HonestLeon/2027_Embedded_Buff/docs/从机代码重构计划.md

# 从机代码重构计划（分阶段）

> 对象：`2027_Embedded_Buff_Slave/`（打符灯板固件）
> 依据：《从机重构清单.md》《代码架构设计.md》《能量机关规则.pdf》5.5.2.1
> 已确认的前置：**CubeMX 配置已完成并校验通过**（6 通道 PWM + 6 条 DMA 全部 `MEMORY_TO_PERIPH`、
> 10 路 EXTI、NVIC 优先级、CAN1=1Mbps+ART/ABOM、USER CODE 区保留）
> 目标：与主机同构的 `config / bsp / application` 分层；**复用主机框架，只换业务层**

---

## 一、总体策略

1. **最大化复用**：主机的 `config/bsp` 框架与 `application/buff.c` 的**协议段**已可直接继承，
   从机真正要新写的是 **`hit_detect`（击打采集）+ 从机状态机 + 灯板图案库**；
2. **口径继承（不标定）**：**硬件与 2025 完全相同** ⇒ 老从机的灯数（87/262/320/120/92）与
   "索引↔功能"映射**就是规格**，直接继承 `config_ws2812.h` / `config_light.h`；
   逐条点亮只作为**排障工具**保留（见《灯带白光自检与排障》），不再是必经阶段；
3. **自底向上，但阶段间不设台架闸门**：S3→S4→S5→S6 **一次性连续写完**，每阶段只过“静态可验项”
   （编译 0 error 0 warning、表/缓冲一致、与主机协议段 diff 一致、代码走查），
   **所有物理验证集中到 S7 一次做**（省反复烧录/上板；代价与对策见 §四 风险表末两行）；
   **S8（进度条）是唯一例外**——它的渲染几何必须"台架 + 机械布局"才能定，排在 S7 之后、复用 S7 台架环境；
4. **时序纪律**：从机必须 **1ms 级排空 CAN**（大符轮次切换的"熄灭/点亮"两帧仅隔 150ms），
   且**禁止 `HAL_Delay` 阻塞**（老从机 200ms 阻塞是"熄灭不稳定"的根因）；
5. **⚠ 从机板未接拨码开关**（实测）：PD2/PB3/PB4 悬空 + 内部上拉 → 三个 `SW_*` 恒为高（恒"激活"），
   因此**颜色/大小符一律取 CAN 帧**（[4]/[2]），**自检只能用 `DEBUG_TEST_MODE` 宏触发**
   （拿 `SW2` 当触发会一上电就永久扫描；`TEST_TRIGGER_USE_SW2` 已置 0）。
6. **测试方法（定死，不再讨论）**：主判据 = **实机观察**（灯带外观、该熄的熄没熄、进度条、环数）
   + Keil 调试器 **Watch 全局变量/结构体快照**；**CAN 分析仪 / CAN 盒不进计划、不作任何阶段判据**。
   配套要求：**每阶段必须交付一个可 Watch 的快照结构体**，S7 只靠变量就能分层定位——
   `S3=g_buff_rx`✅ / `S4=g_dbg_hit`✅ / `S5=g_dbg_slv`✅ / `S6=g_dbg_pat`✅；对外发帧一律用**真主机**（或 5 板联机）。

```
S0 基线 ──► S1 config ──► S2 口径继承(✅无需标定)
                                  └─►╒══════ 连续编码块：阶段间不上台架 ══════╕
                                     ║ S3 bsp 适配  →  S4 hit_detect         ║
                                     ║ S5 从机状态机 →  S6 灯板图案库          ║
                                     ╘═══════════════╤═══════════════════════╛
                                                     └─► S7 唯一一次台架：实机观察 + Watch
                                                                  └─► S8 进度条专项（复用台架环境）
```

---

## 二、阶段任务分解

### S0 基线确认与工程接入（0.5 天）

| # | 任务 | 说明 |
|---|---|---|
| S0.1 | ~~CubeMX 配置~~ | ✅ 已完成并校验（见本文件开头的前置说明） |
| S0.2 | ~~工程改名~~ **已定：不改** | 从机目录内的 `.ioc`/Keil 工程名沿用 `..._Master`（改名要重生 `MDK-ARM/` 并重配 Groups/包含路径，收益仅是名字）。靠目录名 + `BOARD_ROLE_MASTER` 区分主从，结论见《遗留待办与开放问题》R3 |
| S0.3 | ~~编译基线~~ **✅ 2026-10-06** | 用 `arm-none-eabi-gcc -fsyntax-only`(-Wall -Wextra, HAL 头齐全)检查从机全部 config/bsp/application + `main.c`/`it.c`：0 error |
| S0.4 | ~~提交基线~~ **✅** | 从机 CubeMX 配置已随 `5674103`/`e6e113e` 入库 |

**验收**：编译通过；`.ioc` 校验 6 行 DMA 方向全为 `MEMORY_TO_PERIPH`；提交完成。
> 检查命令(本机无 Keil 命令行，语法/类型用 GCC 代跑，**最终 Rebuild 与烧录仍需在 Keil 里做一次**)：
> `arm-none-eabi-gcc -fsyntax-only -mcpu=cortex-m4 -mthumb -std=gnu11 -DUSE_HAL_DRIVER -DSTM32F405xx -Wall -Wextra`
> `  -Iconfig -Ibsp -Iapplication -ICore/Inc -IDrivers/STM32F4xx_HAL_Driver/Inc{,/Legacy} -IDrivers/CMSIS/... `

---

### S1 config 从机化（0.5 天）—— ✅ 已完成（2026-10-06）

> **逐文件改动明细只在《从机重构清单》第三节维护**，本节不抄第二遍。

实际落地的内容：

| 项 | 结果 |
|---|---|
| `config_board.h` | `BOARD_ROLE_MASTER=0`；新增 **`SLAVE_PANEL_NUM`**(1~5) + `#error` 越界检查(填 0/6 直接编译不过，防烧错板)；SW2 曾挪作白光测试触发(`TEST_TRIGGER_USE_SW2=1`)——**此条已被后续实测推翻**（本板未接拨码，悬空恒高会一上电永久扫描），现为 `0`，见总体策略 #5 |
| `config_ws2812.h` | 6 条灯带表，灯数**单点定义**为 `WS_LED_NUM_UP/TARGET/ARM/ARM_SIDE/DOWN/SPARE`(老口径 87/262/320/120/92/0)，表与缓冲都由它推导 → 不会再"改表忘改缓冲"；全 0 时 `#error` |
| `bsp_ws2812.c` | 6 对缓冲按上面的宏开出来：实测 `.bss` **46,208 B ≈ 45.1KB**(PB8 置 0 后)；改用 `s_desc` 描述表展开，**消除 ×6 的 `-Wmissing-field-initializers` 警告**(DoD 要求 -Wall 干净) |
| `config_buff.h` | 逐项标注【主从共用】/【仅主机】(从机不跑大小符状态机)，宏一个没删，保证 S5 之前仍可编译 |
| `config_light.h` | 三张标定表**数值一字未动**；新增从机侧 `SLV_STRIP_*`(画在哪条)、`SLV_LEVEL_*`(亮度，含老进度条那个很暗的 10)、`SLV_ALL_ON_STRIP_MASK`、`SLV_PROGRESS_STEPS=5` |
| 电机 | 删 `config/config_motor.h`、`application/motor.c/.h`；`main.c` 去 `motor_init()`、`it.c` 去 `motor_update()`、Keil `Application` 组去 `motor.c`(`.uvprojx`/`.uvoptx` 已同步) |

**验收**：语法/类型检查 0 error **0 warning**；`grep -rn "MOTOR_\|motor_" application/ config/` 仅剩
`config_can.h` 的 `CAN_ID_MOTOR_TX/FB_BASE` —— 那是主从共用的协议 ID 表（S1 只动 config 的角色/灯带/标定项，`config_can.h` 保持与主机一致），不是残留。
待你在 Keil 里 Rebuild 一次确认(链接/尺寸看 map：45KB 缓冲 + 栈 2KB + 堆 0.5KB，数据区共 128KB，余量充足)。

---

### S2 ✅ 口径继承与灯带缓冲（已完成，无需标定）

> **结论（2026-10，用户确认硬件与 2025 相同）**：老从机的灯数与"索引↔功能"映射**直接继承**，
> 不存在需要标定的未知量。已核对 `config_light.h` 的 `SLV_STRIP_*` 与老代码 DMA 绑定**逐条一致**：
> TARGET=1(老 `LED_ROAD_2`, 262, 靶面/环数)、ARM=2(老 `ROAD_4`, 320)、ARM_SIDE=3(老 `ROAD_5`, 120)、
> UP=0(老 `ROAD_3`, 87)、DOWN=4(老 `ROAD_1`, 92)。PB8（索引5）老从机从不驱动 → `WS_LED_NUM_SPARE=0`
> （不分配/不发送，省 ~4.5KB；缓冲实测 46,208B ≈ 45.1KB）。

| # | 任务 | 状态 |
|---|---|---|
| S2.1 | 补齐灯带缓冲（`bsp_ws2812.c` 6 对，由 `WS_LED_NUM_*` 同源推导） | ✅ 已完成 |
| S2.2 | 口径继承：灯数 + 功能索引映射写进 `config_ws2812.h` / `config_light.h` | ✅ 已完成 |
| S2.3 | PB8（TIM4_CH3）按老行为置 `0`（不驱动） | ✅ 已完成 |
| S2.4 | 逐条点亮（**降级为可选排障工具**，不再是阶段任务） | 工具就绪：`DEBUG_TEST_MODE=1` |

**验收**：灯带表/缓冲/指针表三者一致（6=6=6，改 `SPARE` 后 5 主动通道）；缓冲实测 46,208B ≈ 45.1KB，在主 SRAM(128KB) 预算内。

> 若 S5/S6 联调时发现"某条不亮/某段显示位置不对"，用《灯带白光自检与排障》定位
> （从机未接拨码，**只能用编译期宏触发**）。

---

### S3 bsp 复用与适配（0.5 天）—— ✅ S3.1 已实现(2026-10-06)，只剩台架验收

**S3 只有一处真正的代码改动 = S3.1（CAN 出队从 4Hz 挪到 1ms）✅ 已落地**；其余四项是做决定并记录，不改代码。

#### S3.1 设计决定（照此实现即可，不必再权衡）

| 项 | 决定 | 理由 |
|---|---|---|
| 谁在 1ms 里排空 | 在从机 `application/buff.c` 新增 `void buff_can_rx_poll(void)`，由 `it.c` 的 **1ms 段**调用 | "收帧→解析→更新目标状态"是业务层动作，`bsp_can` 只负责 pop；放进 `buff.c` 后 **S5 换从机状态机时这个函数原样保留**，主从两版的差异仍然只集中在"状态机那一段"，同步成本最低 |
| 排空后做什么 | 逐帧解析，**立刻覆盖目标状态**（`cmd` / 大小符 / 颜色 / `round`）并 `++事件计数`；**不做动画、不发上报** | 目标状态是幂等覆盖 → 主机"全亮"一次连发 5 帧也不会丢帧；熄灭帧在 1ms 内生效，才能满足 §四 的 150ms 两帧时序 |
| 4Hz 还做什么 | `buff_step()` 改为**消费事件槽**（不再自己调 `bsp_can1_pop`），只跑状态抬升 / 灯效动画 / 上报 | 动画需要 250ms 节拍；上报放 4Hz 与老从机语义一致（老从机也是主循环一轮报一次） |
| 队列要不要加深 | **不改**（CAN1 队列仍 16 帧） | 主机最坏突发 = 全亮 5 帧 + 每 250ms 一帧；1ms 排空后队列基本常空 |
| ISR 预算 | 已核算，安全 | 5 条主动灯带里最长 320 灯：`translate` 写 7680 个 `uint16` ≈ 0.18ms@168MHz；每 tick 最多启动 2 条 → 最坏一 tick ≈0.36ms；单条 DMA 发送 320×24×1.25µs ≈ **9.6ms**，5 条并行各自独立定时器 → 全部刷完 ≈12ms << 灯效周期 250ms。**从机 1ms 中断里没有电机环**，比主机宽裕得多 |

**S3 阶段内静态验收**（写完即过，不上台架）：`it.c` 的 1ms 段确实调用 `buff_can_rx_poll()`；
`g_buff_rx` 字段齐全（frames/bad_frames/seq/cmd/is_big/is_blue/panel_a/panel_b/round/age_ms/max_burst）；
从机构建内主机状态机不参与编译（`#if BOARD_ROLE_MASTER`）；语法检查 0 error 0 warning。
**物理判据全部移到 S7 第 1 组**（见 S7 的五组表）。

| # | 模块 | 改动 |
|---|---|---|
| S3.1 | `buff_can_rx_poll()` + `it.c` 1ms 调用 | ✅ **已实现**：从机 `buff.c` 新增接收路径（解析下行 `0x161` → 幂等覆盖目标状态 + `seq`/`frames`/`age_ms`/`max_burst`），`it.c` 在 1ms 段调用。**同时把主机状态机整段用 `#if BOARD_ROLE_MASTER` 在从机构建里关掉** —— 否则从机会每 250ms 往总线发 0x161 跟真主机抢话，还会在 4Hz 里 `bsp_can1_pop` 与 1ms 排空抢同一队列 |
| S3.2 | `bsp_ws2812` | ✅ 复用，**不改代码**（6 条表 + 5 条主动灯带的 ISR 预算已核算） |
| S3.3 | `bsp_switch` | ✅ 文件保留，但**从机业务一律不得读 `SW_*`**：本板未接拨码，悬空+内部上拉恒为高（恒"激活"）。老从机里**没有任何 `HAL_GPIO_ReadPin`**，颜色/大小符全部来自 CAN `[4]/[2]`。⚠ 现在从机编的仍是主机版 `light.c`/`buff.c`，里面有 `bsp_switch_get()` —— 值恒定、暂时无害，但 **S6 换灯效、S5 换状态机时必须彻底改成 CAN 来源**（待办 SL4b） |
| S3.4 | `bsp_rng` | ✅ 暂不动：S5 之前主机版 `buff.c` 的随机段还在编译里；换成从机状态机后从机不再需要随机数，届时再决定是否移除 `srand(bsp_rng_get_seed())` |
| S3.5 | `bsp_can` 的 CAN2 分支 | ✅ **保留，不做条件编译**：老从机同样配了 CAN2 却不用（与老代码一致）；`bsp_can.c` 是主从共用文件，加 `#if BOARD_ROLE_MASTER` 反而扩大两版差异 |

### S4 hit_detect —— 击打采集与环数（1 天）—— ✅ 已落地（2026-10-10），只剩 S7 组 2

| # | 任务 | 说明 |
|---|---|---|
| S4.1 | 新建 `application/hit_detect.c/.h` | ✅ EXTI 回调只记录（引脚+`g_sched_tick_cnt` 时间戳入环形缓冲）；判定全在 4Hz `hit_detect_task()` |
| S4.2 | 环数标定表 | ✅ `KEY1~8 → 10..3`；**KEY9/KEY10 按老代码原值 = 1 环（2 环无对应，疑笔误）→ S7 组 2 实测校正，只改 `s_hit_map[]` 一处** |
| S4.3 | 显式状态 | ✅ `HD_ST_ARMED/FIRED/LOCKED/MISHIT` + 单槽事件（`hit_detect_take`）；语义对齐老 `once`(0/1/2)+`start` 锁存 |
| S4.3b | **沿与去抖** | ✅ 第一道 `.ioc`+`gpio.c` IT_FALLING；第二道 `HD_IGNORE_MS=100ms`（config_buff.h）已实现；打错判据 = 未武装 && 距上一沿>窗（**2026-10-10 验收修正：移除永久"引脚≠上次击发"排除**，§3.4 硬约束③） |
| ⬜ S4.4 | 环数实测（**归 S7 组 2 执行**） | 本阶段只把 `hit_map[]` 写全并留好 Watch 快照；上台架时逐一短接 RDET1~10 记录环数，**重点核对 9/10 号**，回填标定表 |
| S4.5 | 打错判定 | ✅ 未武装 && 距上一沿>窗（**任何引脚**）→ `HD_EV_MISHIT`（状态机上报 `[2]=0x01` 并回休眠）；与老代码"锁存外从不看引脚"一致 |

**S4 静态验收（2026-10-10 已过）**：`s_hit_map[]` 10 条与 `main.h` KEY 宏逐一对应（PA1~5/PC6~10 =
老 RDET1~10）；EXTI 回调只做"记引脚 + 记时间戳"，表外引脚只计数返回；语法 0 error 0 warning；
`g_dbg_hit` 已交付（S7 组 2 主判据）。**物理判据 → S7 第 2 组**。

---

### S5 从机状态机（`buff.c` 换掉主机构建专用段）（1 天）—— ✅ 已落地（2026-10-10），只剩 S7 组 3

> 状态定义、解码规则（哪些命令看灯板号、哪些广播）、上报字节、打错处理与状态清理 ——
> **全部在《从机重构清单》§3.3 与 §七（协议速查）维护**，本处不重复。

两条最容易漏的：协议段（`buff_frame_pack/parse`、`buff_send_frame`、`buff_slave_report_parse`）
**逐字节不动**（主从共享真相源）；进入 `SLV_ACTIVATED` 的瞬间**只上报一次**。

#### S5 设计决定（2026-10 预检定稿，照此实现即可）

| 项 | 决定 | 理由 |
|---|---|---|
| 事件消费 | `buff_can_rx_poll()`（从机侧）在镜像之外加**本机事件锁存**：帧满足"板号命中(`0x01/0x02`)或广播(`0x03/0x04`)" → 覆写 `my_ev_cmd` + 置 `my_ev_valid` + `my_ev_seq++` | 现在 `g_buff_rx.cmd` 只镜像"最后一条有效帧"：4Hz 窗口内若"别人的帧"后到，按 `cmd` 判定会**丢掉发给自己的熄灭帧** —— 等于把老单缓冲覆盖缺陷从驱动层搬进业务层 |
| 状态转换时机 | 收帧触发的转换（熄灭/点亮/复位/全亮）在 **1ms 的 `buff_tick()`** 里消费锁存并立即换态 | 主机熄灭→点亮只隔 150ms < 250ms 逻辑帧窗口；若 4Hz 才换态，"先熄后亮"会塌缩成"只见点亮"，中间熄灭不可见 → 违反规则"熄灭至多 200ms"的意图 |
| 4Hz 职责 | `buff_step()` 只做：消费击打事件（HIT→`ACTIVATED`+上报一次 / MISHIT→`SLEEP`+打错上报）+ 灯效场景刷新 | 上报与动画节拍 = 老从机 ≈200ms 主循环，不比老代码慢 |
| 转态作废在途击打（差异表 #22） | `slv_enter()` 先 `hit_detect_flush()`(清 EXTI 记录环 + 待消费事件)，`buff_step()` 消费时再校验 `s_slv==SLV_ARMED` | 击打记录由 1ms EXTI 采、4Hz 判定，跨度最长 250ms；若期间主机发来熄灭帧(150ms 间隔)，旧记录会在转态后被判成"打错"→ 主机整体复位，表现为"被打过的板熄灭后一直不亮" |
| 隐式熄灭（差异表 #21） | 大符点亮帧 = "本轮该亮的集合"：不在 `[3]/[5]` 里的板按熄灭处理 | 熄灭帧丢失时残留板在下一轮点亮自愈（台架实测过"3 块同时亮"）；小符不加，避免打过的板丢环数 |
| 重复命令语义 | 已处于目标态再收同命令帧 → **不重复清屏/不重新武装**（状态不变即 no-op） | 复刻老 `Decode()`：`state` 赋同值时 `last_state` 判断不成立 → 无清屏；`once` 只在 SLEEP 分支清零 |

**S5 静态验收（2026-10-10 已过）**：协议段与主机版逐字节一致（diff 命中 = 仅 S3.1 接收路径与
`#if` 门/从机段；已实测 diff 为空）；板号匹配只作用于 `0x01/0x02`，`0x03/0x04` 按广播处理
（在 1ms `buff_can_rx_poll` 逐帧锁存 `my_ev_*`）；进入 `SLV_ACTIVATED` 的上报路径**只有一条且一次性**
（`slv_enter` 唯一入口）；全程无 `HAL_Delay`；语法 0/0；`g_dbg_slv` 已交付。
**物理判据 → S7 第 3 组**（对接真主机 + Watch `g_dbg_slv`）。

---

### S6 灯板图案库（`light.c` 换成从机图案）（1~1.5 天）—— ✅ 已落地（2026-10-10），只剩 S7 组 4

> 四种外观各画在哪条灯带、用哪张标定表 —— **在《从机重构清单》§3.5 与 §五（差异表 #1/#6）维护**。
> ⚠ **本阶段口径 = 纯复刻老从机**：老代码没画过的图案（进度条 n/5）本阶段一律不做，归 S8。

| # | 任务 | 说明 |
|---|---|---|
| S6.1 | 动画节拍 | 老代码靠 4Hz 主循环 + `i`/`test_num` 两个补丁变量喂相位 -> 新实现用**逻辑帧计数 + 模块内自持相位**（与主机 `light.c` 同风格），不再有外部补丁变量 |
| S6.2 | 已激活态灯臂/侧灯臂（小符复刻 / **大符打中即熄灭**） | 老代码是 ARM(320)+ARM_SIDE(120) **两条整条常亮、定值 10**，与收到的 `[6]` 无关 → 本阶段照抄两条整条常亮，亮度用 `SLV_LEVEL_*`（10/80 观感定值归差异 #14 → S7 组 4 定）。**n/5 分段点亮 = 规则要求的新增功能，本阶段不实现，移 S8 专项**（旧根因与新链路结论见 S8 节） |

**S6 静态验收（2026-10-10 已过）**：三张标定表与老从机数值逐条核对无改动（19 段 / 10 组环数 /
6 行箭头 + 11 份偏移叠加 + 1 环六段特例，均照 `Divice/WS2812.c` 与老 `main.c` 原样）；图案只写
`SLV_STRIP_*` 指定的条；整版清屏只在 `light_set_scene()`（状态转换）一处；箭头相位 = 模块内
`s_phase/s_phase_div` 自持（每 4 逻辑帧一步，无 `i`/`test_num` 式补丁变量）；
**ACTIVATED 态两条灯臂整条常亮、代码与 `g_buff_rx.round` 无任何关联（复刻口径）**。
语法 0/0；`g_dbg_pat` 已交付。**物理判据 → S7 第 4 组**（与规则图 5-20/5-21/5-23 实机对照 + Watch `g_dbg_pat`）。

---

### S7 台架总验收（1 天 · 唯一一次上板，覆盖 S3~S6 全部物理判据）

> **判据只用两种手段：实机观察 + 调试器 Watch 全局变量/结构体**（`g_sched_tick_cnt`、`g_buff_rx`、
> `g_dbg_hit`、`g_dbg_slv`、`g_dbg_pat`、`bsp_can1_rx_drop_count()`）。**不用 CAN 分析仪 / CAN 盒**。
> 逐项清单仍以《从机重构清单》§六 ①~⑭ 为唯一出处；本节定的是**执行顺序与放行规则**。
> **操作步骤 / 记录表 / 故障树 → 见 [`从机S7台架测试指南.md`](从机S7台架测试指南.md)**（开工前照其 §〇 准备一次到位）。

**五组按依赖串行（组 1~4 是 S3~S6 各自的物理判据，组 5 是联机与烤机收尾），前一组不过不开后一组**：

| 组 | 实机看什么 | Watch 什么（主判据） | 对应 §六 |
|---|---|---|---|
| 1 收帧 | 点灯/熄灭/复位/全亮指令是否即时生效；大符轮次切换旧对确不熄 | `g_buff_rx.frames/seq` 随帧增长、`cmd`/`round` 等于本帧、`age_ms` 稳定 1~2、`bad_frames` 与 `bsp_can1_rx_drop_count()` 恒 0 | ⑥⑦⑪ |
| 2 击打 | 10 路逐路触发（短接 RDET1~10）、环数显示、休眠态/已激活态被击是否算打错 | `g_dbg_hit.fire_cnt/mishit_cnt/last_pin/last_circle/age_ms`（**重点：RDET9 到底几环**） | ②⑩ |
| 3 状态机 | 小符 5 块依次点亮→击中→下一块、打错复位、第二块起 2.5s；大符 5 组 + 首击 1s 窗口 + **旧两块确实熄灭**；⑩ 边界两种打法：打**已激活的板**(含再打同一环，验收修正后应报打错)与休眠的板 | `g_dbg_slv.state`/`circle`/`round`/`report_hit`/`report_mishit`/`hit_ev`/`mishit_ev`（进 ACTIVATED 只报一次）；组 1 计数不清零 | ⑥⑨⑩⑫ |
| 4 外观 | 待激活图案 + 箭头流动、环数 1~10 段、已激活态灯臂/侧灯臂**整条全亮**（复刻口径，不查 n/5）、全激活，逐条对照规则图 5-20/5-21/5-23 | `g_dbg_pat.strip/pattern/phase`；亮度不对先查 `SLV_LEVEL_*`（位序陷阱见 §五 #14） | ①③④⑧ |
| 5 收尾 | 5 块板同总线不串扰（逐块核板号）；连续 2h 无死机/花屏；出厂配置 | `g_sched_tick_cnt` 持续涨、drop 计数恒 0、`DEBUG_TEST_MODE=0` | ⑫⑬⑭ |

> **组 1 的发帧前提**（新解析比老 `Decode()` 严）：只有 ID=`0x161`、`[0]=0xAA`、
> `[1]∈{0x01,0x02,0x03,0x04}`、`[3]≤5` 且 `[5]≤5` 的帧才计入 `frames`/`seq`，其余进 `bad_frames`
> （老从机什么帧都吃，所以照老协议注释发 `[1]=0x00` 会“看起来没收到”）。排查顺序：
> `frames` 不涨 → 看 `bad_frames` → 看 `bsp_can1_rx_drop_count()` → 看 `g_sched_tick_cnt` 是否在动。

**放行规则**：组 1→5 串行，任一组不过就停在组内修复后整组复跑；组 5 烤机出现异常需回到对应组复查并在 §六 打勾处记现象。

### S8 进度条专项（0.5~1 天 · S7 全绿后开做，复用 S7 台架/联机环境）

> **为什么单列一个阶段**：进度条是全链路**唯一没有老代码口径可继承**的功能 —— 2025 旧代码从未把它画出来过。
> 旧链路根因（2026-10 静态分析定案，逐行核过老 `master_work()` 与老从机 `Decode()`）：
>   ① **主因（从机未渲染）**：老从机把 `[6]` 存进 `counter` 后**从未使用** —— state 3 的"进度条"是
>      **写死的整条常亮 10**（ARM+ARM_SIDE 两条全亮），与收到的值零关联；
>   ② 次因（主机帧残留）：老主机复位帧/全亮帧/小符分支不写 `[6]`，靠字节残留 → 复位后进度会残留旧值。
> 新链路**已闭环、无需再查**：新主机 `buff_frame_pack()` 每帧全字节打包、`send_cmd()` 每次都填 `round`
> （复位=0 / 熄灭=s_round / 点亮=s_round / 全亮=s_round，老"残留"缺陷已消除，主机已上机验证）；
> 新从机 1ms `buff_can_rx_poll()` 已存 `g_buff_rx.round`。
> **剩余不确定全部在"怎么画"**，必须台架 + 机械布局才能定：哪条是"中部灯臂"、320/120 颗怎么分 5 段、
> 侧灯臂参不参与、亮度 10/80（位序陷阱，差异 #14）。

| # | 任务 | 说明 |
|---|---|---|
| S8.1 | 链路复核（纯观察） | 真主机跑大符全程，Watch `g_buff_rx.round` 随轮次递增（首次点亮 0 → 每击中一组 +1 → 全亮 5）、复位帧后归 0 |
| S8.2 | 定渲染几何 | 与机械/队伍确认"中部灯臂"指哪条 + 分段几何，对照规则图 5-21"已激活"外观 |
| S8.3 | 实现 | 按 `round` 分段点亮（替换 S6 复刻的整条常亮），亮度沿用 S7 组 4 的定值结论 |
| S8.4 | 回填 | 分段标定写进 `config_light.h`（单一来源），验收结论回填本节与《从机重构清单》§六 ⑤ |

**S8 验收**：大符全程进度 0/5 → 4/5 → 5/5（全亮）正确递增；打错/2.5s 复位后**立即回 0/5**
（新主机每帧全写 `round`，老"复位残留"缺陷不复现）；小符不受影响（round 恒 0，不画进度）。
对应《从机重构清单》§六 ⑤。

## 三、里程碑与工期

| 里程碑 | 内容 | 累计 |
|---|---|---|
| M1 | 基线 + config 从机化 + **口径继承**（S0~S2，含灯带缓冲） | ✅ 已完成 |
| M2 | **S3~S6 代码全部落地**（一次连续编码；阶段间不上台架，只过各阶段静态可验项） | ✅ 2026-10-10（待 Keil Rebuild 复确认链接/尺寸） |
| M3 | **S7 唯一台架**：五组串行判据 + 5 板联机 + 2h 烤机全绿 | 5 天 |
| M4 | **S8 进度条专项**：链路复核 + 渲染几何确认 + 实现 + 验收（复用 S7 台架环境） | 6 天 |

## 四、风险与依赖

| 风险 | 影响 | 缓解 |
|---|---|---|
| **RDET9 环数映射错误**（老代码疑为笔误，2 环无对应） | 2 环打不出来 / 环数显示错 | 标定表单一来源（只有 `hit_map[]` 一处）；逐路实测校正归 **S7 组 2**，短接 + Watch `g_dbg_hit` 即可，不用仪器 |
| **灯带通道与丝印错位**（主机板教训） | 灯效画错条 | 从机口径取老从机的 **DMA 绑定**（不是丝印、也不是主机版数值），`SLV_STRIP_*` 已逐条核对一致；真出现“某条不亮/段位不对”再用《灯带白光自检与排障》定位 |
| **PB8(TIM4_CH3) 接线** | 灯带表条数 | 已按老行为定案：老从机**从不驱动**该口 → `WS_LED_NUM_SPARE=0`（不分配/不发送）。若硬件确实与 2025 不符，改这一处宏即可 |
| **“全激活”外观无定论** | 与规则图不符 | S6 图案实现时按老从机口径先做 + 与队伍确认；**S7 组 4** 与规则图 5-23 实机对照 |
| **进度条渲染几何无老口径**（老代码从未实现，根因 2026-10 已定案：从机未渲染 + 主机 `[6]` 残留） | n/5 只能凭想象定几何，易做错 | 数据链已闭环（新主机每帧全写 `round`，已上机验证）；渲染几何（哪条/怎么分段/亮度）归 **S8**，机械 + 台架确认后再实现 |
| **老从机 200ms 单缓冲缺陷** | 若沿用老结构，"熄灭"永远不稳定 | S3.1 已强制 1ms 排空 CAN（代码✅）；**S7 组 3** 专项验收旧对确不熄 |
| **灯数与实际不符** | 末端不亮/多亮 | 灯数继承老 `WS2812.h`(87/262/320/120/92)，正确性由“老固件整季实机运行”背书；若某条末端有残点，按《灯带白光自检与排障》点数后改 `WS_LED_NUM_*` 一处 |
| **5 块板程序烧错**（按板编译） | 灯板号错乱 | 固件文件名带板号；**S7 组 5** 联机时逐块核对 |
| **阶段间不上台架 → 缺陷集中在 S7 暴露** | 定位面大，返工挤占联调窗口 | ①每阶段静态可验项当闸门（编译/0 警告、表-缓冲一致、协议段 diff、代码走查）；②S3~S6 各留一个 Watch 结构体，S7 只看变量即可分层定位；③S7 五组严格按依赖串行，前组不过不开后组 |
| **不用 CAN 分析仪 → 缺帧级证据** | 协议扯皮时只能靠软件计数与现象 | 判据内建进固件：`g_buff_rx`(frames/bad_frames/age_ms/max_burst) + 收发 drop 计数 + `g_dbg_hit/slv/pat`；外观与熄灭类问题本就靠实机观察；真需帧级旁证按临时手段处理，不写进计划、不排期 |

---

## 五、完成定义（DoD）

> 逐项操作步骤见《从机重构清单》§六；本节是**签核口径**（打勾即交付）。

- [ ] 5 块板全部烧录正确板号并同时在线，无串扰
- [ ] 小符/大符全流程与规则一致（含打错复位、2.5s、1s 窗口、**轮次切换熄灭**）
- [ ] 环数 1~10 显示与击打位置逐一对应（含 2 环）
- [ ] 中部灯臂进度 n/5 正确递增（**S8 专项验收**，S7 不含此项）
- [ ] 四种状态外观与规则图对照通过
- [ ] 从机响应延迟 ≤1ms（150ms 熄灭间隔可靠生效）
- [ ] 2h 烤机无异常；全部代码 `-Wall` 无警告；文档回填完毕

---

## 六、可复用资产清单（省一半工作量）

| 资产 | 来源 | 从机用法 |
|---|---|---|
| `bsp_ws2812.c` 驱动（PWM+DMA、dirty/busy、帧完成回调） | 主机 | **直接用**，只改灯带表与缓冲 |
| `bsp_can.c`（过滤器/双队列/零等待发送/计数） | 主机 | **直接用**，S3.1 调整排空节奏 |
| `bsp_switch.c` / `bsp_rng.c` | 主机 | 直接用 |
| `buff.c` 协议段（pack/parse/上行解析） | 主机 | **逐字节不动**（主从共享真相源）|
| `config_light.h` 标定值（环数表/待激活段/箭头模板） | 2025 老从机 | 一字不改地继承 |
| `light.c` 的 `bsp_ws2812_set_rgb/fill` 调用风格 | 主机 | 图案层按同样风格写 |
| 调度骨架（`it.c` 1ms/4Hz） | 主机 | 替换业务调用即可 |
