HonestLeon/2027_Embedded_Buff/docs/从机S7台架测试指南.md

# 从机 S7 台架测试指南（唯一一次上板 · 五组串行）

> 目的：一次性完成 S3~S6 全部**物理判据**验收（收帧 → 击打 → 状态机 → 外观 → 联机/烤机）。
> 手段**只有两种**（已定死，不引入新工具）：**实机观察**（灯带外观、该熄的熄没熄）+
> Keil 调试器 **Watch 全局变量/结构体**。**不用 CAN 分析仪 / CAN 盒**。
> 前置：S4~S6 代码已落地且静态验收全过；**从机 Keil Rebuild 0 error**；发帧一律用**真主机**
> （主机 P4~P6 已实测通过）或 5 板联机。
> 判据出处：逐项清单以《从机重构清单》§六 ①~⑭ 为**唯一判据出处**，执行顺序/放行规则以
> 《从机代码重构计划》S7 为准；**本文是"怎么测"的操作步骤 + 记录表**。
> ⚠ ⑤ 进度条 n/5 属 S8 专项，**S7 不测**；S7 全绿后台架环境直接留给 S8。

---

## 〇、开工准备（一次做完，后面各组不再动烙铁）

### 0.1 器材清单

| 器材 | 数量 | 说明 |
|---|---|---|
| 从机板（打符灯板） | 组 1~4 用 1 块；**建议直接烧好 5 块**（组 3/5 需要） | 烧录配置见 0.2 |
| 主机板 | 1 | 已联调通过；SW1/SW3 拨码是"发帧遥控器"（见 0.4） |
| 调试器 | 1 | ST-Link/J-Link，从机组 2/3 要 Watch，**全程挂着从机调试口** |
| 短接线/鳄鱼线 | 1 根 | 短接 RDET 端子→GND 模拟弹丸击打（击打=拉低产生下降沿，与触发沿配置一致） |
| CAN 线 | 按既有联调接法 | 主机 CAN1 ↔ 从机 CAN1（PA11/PA12 侧）；**共地**；接线沿用主机 P4~P6 联调那套即可 |
| 供电 | 灯带 24V（经板）+ 调试 USB | TJA1044 STB 若经上拉未使能会**完全不发**（待办 H2，故障树见 §六） |
| 手机 | 1 | 外观拍照/录像留档（组 4 对照规则图必需） |

### 0.2 固件烧录（⚠ 每块板两处，烧错必串扰）

1. `config/config_board.h`：`SLAVE_PANEL_NUM` = 1~5（**每块板唯一**，越界会 `#error`）；
   `DEBUG_TEST_MODE` = **0**（正常固件；只有组 4 排障"某条不亮"时才编 =1 的调试固件，用完换回）；
2. Keil Options→Output→**Name for Executable 改成 `Buff_Slave_P<n>.hex`**（n=板号）；
3. Rebuild → 烧录 → **板上贴标签**；5 块板逐块核对"文件名↔宏值↔标签"三一致。

主机板烧最新已验证固件即可。**从机板没有拨码开关（未装配）**：颜色/大小符全部来自主机 CAN 帧，
从机侧无任何 SW 参与——这本身就是被测行为（S3.3/SL4b），测试时**不要在从机上找拨码**。

### 0.3 烧好 Watch 视图（调试会话开始前一次配齐）

| 分组 | 变量 | 含义速查 |
|---|---|---|
| 心跳 | `g_sched_tick_cnt` | TIM6 每 1ms +1；不动 = 调度没跑（先看它！） |
| 收帧 | `g_buff_rx` | `.frames/.seq/.bad_frames/.age_ms/.max_burst/.cmd/.panel_a/.panel_b/.round/.my_ev_cmd/.my_ev_valid/.my_ev_seq` |
| 击打 | `g_dbg_hit` | `.edges/.fire_cnt/.mishit_cnt/.ignored/.stray/.rec_over/.ev_lost/.last_pin/.last_circle/.armed/.st/.ev/.age_ms` |
| 状态机 | `g_dbg_slv` | `.state/.circle/.ev_cmd/.armed/.ev_cnt/.hit_ev/.mishit_ev/.report_hit/.report_mishit/.is_big/.is_blue/.round` |
| 图案 | `g_dbg_pat` + `g_dbg_ws_scan_idx` | `.scene/.blue/.circle/.phase/.phase_div/.test` |
| CAN 丢帧 | `s_can1_rx_drop` / `s_can1_tx_drop`（`bsp_can.c` 内 static） | Keil Watch 直接输变量名选 `bsp_can.c` 实例即可；等价于 `bsp_can1_rx_drop_count()` |

**枚举值对照**（Watch 里读到的是数字）：

| 数字含义 | 0 | 1 | 2 | 3 | 4 |
|---|---|---|---|---|---|
| `g_dbg_slv.state` / `g_dbg_pat.scene` | 休眠 SLEEP | 待激活 ARMED | 已激活 ACTIVATED | 全激活 ALL_ON | — |
| `g_dbg_hit.st` | LOCKED 未武装 | ARMED 可击发 | FIRED 已击发待消费 | MISHIT 待报打错 | — |
| `g_dbg_hit.ev` | 无事件 | HIT | MISHIT | — | — |
| `.cmd`/`.ev_cmd` | — | 0x01 熄灭 | 0x02 点亮 | 0x03 复位 | 0x04 全亮 |

`last_pin` 是 GPIO 位掩码 → **0x02=KEY1、0x04=KEY2、0x08=KEY3、0x10=KEY4、0x20=KEY5、
0x40=KEY6、0x80=KEY7、0x100=KEY8、0x200=KEY9、0x400=KEY10**（引脚 PA1~5/PC6~10 = 老 RDET1~10）。

### 0.4 主机 = 发帧遥控器（操作对照）

| 想发生的帧 | 主机操作 |
|---|---|
| 上电复位 `0x03` + 点亮第一块 `0x02` | 主机上电即自动发（约 0.5s 内两帧） |
| 红/蓝 | 主机 SW3（低=红 高=蓝）→ 下一帧起从机即时换色 |
| 小符/大符 | 主机 SW1（低=小符 高=大符）；中途切换主机会整体复位重来 |
| 击中推进/全亮 `0x04`×5 | 真击发（短接当前点亮板的 RDET），打完主机自动发全亮 |
| **熄灭旧对→点亮新对（隔 150ms）** | 大符打中第一块 → 等 1s 窗口结束自动发（组 3 核心观察点） |
| 打错复位 | 从机上报 `[2]=0x01` → 主机收报后自动复位重发（不用拨任何开关） |
| 2.5s 超时复位（**仅小符**） | 小符第二轮起不打，等 2.5s 主机自动发 `0x03` |
| **大符"没打中就换一对"（M9）** | 什么都不用做：大符点亮一对后 2.5s 内没人打 → 主机自动发 `0x01`→150ms→`0x02`（**新板对**），进度不变、不复位；Watch 主机 `g_dbg_buff_refresh` |
| SW2（停/转） | 只控电机，**不影响发帧**；台架可不接电机 |

### 0.5 击打模拟手法（避免自己制造"鬼数据"）

- 触发：短接线把目标 **RDET_n 端子→GND 点一下即松开**（下降沿=一次击打）；
- 要"干净的两次击打"：**间隔 ≥300ms**（<100ms 会被去抖窗当同一击的抖动吞掉——那是预期行为，
  不是 bug，见组 2 边界表）；
- 组 2 判定环数：看**靶面亮的段位**（对照下表）+ `g_dbg_hit.last_circle` 互证。

**环数 ↔ 靶面段位查表**（`LIGHT_RING_MAP`，靶面 262 颗上的 {起始,长度}）：

| 环数 | 10 | 9 | 8 | 7 | 6 | 5 | 4 | 3 | 2 | 1 |
|---|---|---|---|---|---|---|---|---|---|---|
| 段 | 0~48 | 49~93 | 94~132 | 133~165 | 166~195 | 196~220 | 221~236 | 237~249 | 250~257 | 258~261 |

---

## 一、组 1 · 收帧链路（对应清单 ⑥⑦⑪）

> 目标：1ms 排空 + 解析 + 本机事件锁存全链路正确。**外观先不管对错，只看"帧进得来、事件锁得住"。**

**接线**：主机 ↔ 从机（板号=1 那块）单挂 CAN1，从机接调试器。

**步骤**：

1. 从机上电（调试会话开始、跑到 `while(1)`/软 halted 都行——TIM6 调度在跑即可），
   确认 `g_sched_tick_cnt` 持续增长；
2. 主机上电 → 自动发 `0x03` + `0x02`（点亮第一块，板号大概率≠1）：
   Watch `g_buff_rx`，**帧数随主机每个动作跳增**（上电复位/点亮/熄灭/超时/全亮）；
   ⚠ 主机只在状态转换点发帧、**等待期间不发**——空闲时不涨是正常的，查的是"每个动作点都跳"；
3. 对照下表判据；异常走 §六 故障树；
4. 主机 SW1 拨大符再拨回（触发主机复位连发）→ `frames` 继续涨、`bad_frames` 恒 0；
5. 观察**全亮 5 连发**：`max_burst` 出现 **5 属正常**（一次 poll 排空 5 帧）；
   ⚠ 单板打不穿小符 5 轮（其它板没人击打 → 主机 2.5s 超时复位）——**本项顺延到组 3/组 5
   五板在线时补记**，组 1 先按"通过判据"放行；
   持续 >1 才说明排空慢（正常每拍 1~2 帧）；
6. 记下 `age_ms`：持续发帧时**稳定在 1~2**（=1ms 排空节奏，⑪ 时序判据）。

**判据**：

| 变量 | 期望 | 不满足时 |
|---|---|---|
| `g_buff_rx.frames` / `.seq` | 主机每个动作点都跳增（复位/点亮/熄灭/全亮）；空闲不涨=正常 | →§六 四步排查 |
| `g_buff_rx.bad_frames` | **恒 0**（真主机发的帧必然合法） | 有增长=接线串扰/ID 过滤器问题 |
| `g_buff_rx.age_ms` | 1~2（发帧期间）；停发后=s 秒×1000 | 恒 0xFFFF=从没收到过 |
| `g_buff_rx.my_ev_seq` | ≤frames；广播(0x03/0x04)与板号命中时 +1 | 恒 0=板号宏没对上 |
| `s_can1_rx_drop` / `s_can1_tx_drop` | **恒 0** | 看故障树第 3 步 |
| `g_dbg_slv.state` | 复位帧后 0；点亮帧板号含 1 时变 1 | 不收事件→看 my_ev |

**组 1 通过判据**：上表全绿 + 至少一次"主机发 0x02 含板号 1 → `state` 1ms 级变 1、
发 0x01/0x03 → 变 0"。记录：

| 项 | 实测 |
|---|---|
| frames 增速 / 稳态 age_ms | |
| max_burst（全亮时，**可组 3/5 补记**） | |
| bad_frames / 双向 drop | |
| ⑪ 判据 age_ms=1~2 是否成立 | ☐ |

---

## 二、组 2 · 击打采集与环数（对应清单 ②⑩；**本组产出两个定案**：RDET9 环数、打错边界）

> 前置：主机已点亮**本机**（`g_dbg_slv.state==1`、`g_dbg_hit.armed==1`）。没点亮就短接=打错，
> 那属于下面的边界测试，别和这里混。

**步骤 A：10 路逐路核对（每路：先复位再打）**

每路流程：主机发 0x02 点亮本机（或等下一轮）→ **短接 RDET_n** → 观察靶面亮段 + Watch →
主机侧因打错/超时复位或重新点亮 → 下一路。记录表：

| 短接 | 期望环数(老口径) | 靶面亮段(查 0.5 表) | `last_circle` | `fire_cnt` | `report_hit` | 备注 |
|---|---|---|---|---|---|---|
| RDET1 | 10 | | | | | |
| RDET2 | 9 | | | | | |
| RDET3 | 8 | | | | | |
| RDET4 | 7 | | | | | |
| RDET5 | 6 | | | | | |
| RDET6 | 5 | | | | | |
| RDET7 | 4 | | | | | |
| RDET8 | 3 | | | | | |
| **RDET9** | **1（⚠疑笔误，应为 2？）** | | | | | **定案栏**：外观实亮段=____环 → 表改不改：____ |
| **RDET10** | 1 | | | | | 1 环显示=六段叠加{1,2,4,6,8,10}，属预期 |

> ⚠ KEY9/10 触发时靶面是 **1 环六段特例**（同时亮 6 个段），别误判成"花屏"；
> 判"环数"看**最内圈有没有亮**+对照上表段位。
> 若实测 RDET9 应为 2 环：只改 `application/hit_detect.c` 的 `s_hit_map[]` 一处并重烧。

**步骤 B：打错/去抖边界（验收修正后的新判据，全部要过）**

| # | 场景 | 手法 | 期望 | 变量证据 |
|---|---|---|---|---|
| 1 | **休眠态被击** | 先复位(state=0)，短接任意路 | 上报打错，主机复位 | `mishit_cnt`+1、`report_mishit`+1、`g_dbg_slv.mishit_ev`+1 |
| 2 | **已激活再打另一环**（间隔≥300ms） | 打中→state=2→短接其它路 | 打错上报并回休眠 | 同上 |
| 3 | **已激活再打同一环**（2026-10-10 修正点） | 打中 RDET1→state=2→隔 ≥300ms 再打 RDET1 | **也报打错**（老反馈的"永久吞"bug 修复验证） | 同 #2，不再是 `ignored+1` |
| 4 | 快速双碰（<100ms 内两个沿） | 一次击打蹭到相邻两环 | 吞成一次击发（不报打错） | `ignored`+1，`mishit_cnt` 不涨 |
| 5 | 击发→上报只一次 | 打中后 5s 不打 | `report_hit` 恰好 +1 不再涨 | ⑥ 判据 |
| 6 | 杂散中断 | —— | `stray` **恒 0**（10 路以外的沿不该出现） | 非 0 → EXTI/线序问题 |
| 7 | 缓冲压力 | 正常手动击打 | `rec_over`/`ev_lost` **恒 0** | 非 0 → 记录消费异常 |

**组 2 通过判据**：表 A 十路环数全部与表位一致（RDET9/10 结论已填入"定案栏"）+ 表 B 七条全过。

---

## 三、组 3 · 状态机全流程（对应清单 ⑥⑦⑨⑩⑫；需要 **5 块板在线**，一次烧好别换）

> 前置：组 1/2 全绿；5 块板挂同一 CAN1；Watch 主机调试器**或**盯从机外观。

**步骤 A：小符全流程**（主机 SW1=小符、SW3 红/蓝各跑一遍）

| 观察点 | 期望 | 证据 |
|---|---|---|
| 每轮只亮"被点名"的板 | 其余 4 块全灭（点名=帧 [3]/[5] 含其板号） | 实机 |
| 点亮→打中→**下一块亮、旧的保持已激活态**（环数+灯臂常亮） | 主机收报推进 | 被打板 `report_hit`+1、`state`2 |
| **打错复位**：故意打一块**没点亮**的板 | 全场熄灭、主机重来 | 该板 `mishit_ev`+1；所有板 `state`→0；主机 `g_dbg_buff_state` 回 BB_RESET(0) |
| 小符打完 5 块 | 主机发全亮 ×5 → 所有板 `state`→3 | 各板 `g_dbg_slv.ev_cnt` |

**步骤 B：大符 5 组 + ⑦ 熄灭（最关键项）**

| 观察点 | 期望 | 证据 |
|---|---|---|
| 对组点亮 | 两块同时进待激活外观 | 两板 `state`→1 |
| 打中第一块→1s 窗口内打第二块 | 第二块**照常上报**（`report_hit`+1）但主机 1s 内不推进（差异 #10 验证） | 两板计数字段 |
| **轮次切换（⑦）**：窗口过后 | **旧两块肉眼可见先熄灭（≈150ms），再点新对**——老从机"熄灭不稳定"专测；**切换完成后全场只应有 2 块亮**（出现第 3 块 = 熄灭帧丢失/板号重复，见 §六故障树；隐式熄灭 #21 会在下一轮自愈） | 实机 + 旧板 `ev_cmd`=0x01→`state`0，随后 0x02→1；各板 `g_buff_rx.imp_off` 应**恒 0**（>0 即曾丢熄灭帧） |
| **未击打周期刷新（M9，新）** | 点亮一对后**两块都不打** → 每 2.5s 自己"熄灭旧对→点亮新一对"；**不复位、进度不推进** | 该两板 `ev_cmd` 交替 0x01/0x02、`state` 0↔1 循环；主机 `g_dbg_buff_refresh` 递增而 `g_dbg_buff_round` **不变**；连续换出的板对不重样（10 组合池） |
| 大符不打第二块 | 打中第一块 → 1s 窗口到点就换下一组（第二块打不打都换）；**大符不再因"没打中"整局复位**（小符仍 2.5s 复位） | 窗口内打第二块：`report_hit`+1 但主机不额外推进（差异 #10） |
| #19 窗口差异**知情项** | 已激活板上 **100~400ms 内再蹭第二环**：新固件会判打错复位整轮（老固件吞掉不复位）——这是有意的收紧，测试时**故意复现一次**并记录，赛场若误报改 `HD_IGNORE_MS`（config_buff.h 一处） | `mishit_ev`+1 |

**步骤 C：⑩ 边界补刀**：全激活(state=3)时再打任一板 → 报打错复位（休眠态打错同路径，组 2 已测）。

**组 3 通过判据**：小符 5 块完整轮 + 大符 5 组完整轮各 1 遍无卡死、⑦ 熄灭清晰可见、
**大符点过的板对互不相同**（主机改为 10 种组合"领用池"逐个取，含未击打时的刷新换出，
若同一对点亮两遍 = 主机侧回归，见《遗留待办》M8/M9）、
打错复位每次生效、各板 `s_can1_tx_drop` 恒 0（上报发得出去）。

---

## 四、组 4 · 外观与灯效（对应清单 ①③④⑧；对照规则图 5-20/5-21/5-23 拍照）

> 单块板 + 主机即可；颜色/图案对照下表逐项打勾。**某条完全不亮/段位不对才用《从机灯带自检
> 与排障》（DEBUG_TEST_MODE=1）定位，口径本身无需标定。**

| # | 场景 | 期望外观（复刻老从机） | Watch 证据 | 实测/结论 |
|---|---|---|---|---|
| 1 | ARMED 靶面 | 262 颗上 **19 段**点亮（段位=`LIGHT_ARMED_SEGS`），亮度 255 不刺眼档 | `g_dbg_pat.scene`=1 | ☐ 对照图 5-20 |
| 2 | ARMED 灯臂 | 320 颗上 **11 份箭头**（每份 14 颗），流动**每 ≈1s 步进一次**（不是 250ms！） | `.phase` 0→3 循环、`.phase_div` 0~3 | ☐ 箭头方向/节拍与老观感 |
| 3 | ARMED 箭头亮度 | 定值 10 档（老观感≈80）**台架定值点①**：太暗 → `SLV_LEVEL_ARROW` 改 80 | — | ☐ 用 10 / ☐ 改 80 |
| 4 | ACTIVATED 环数 | 10..1 环亮段与 0.5 查表一致（组 2 已顺带测，此处核对**观感连续无残段**） | `.circle` | ☐ |
| 5 | ACTIVATED 1 环 | 六段{1,2,4,6,8,10}叠加，属预期 | `.circle`=1 | ☐ |
| 6 | ACTIVATED 灯臂/侧灯臂 | **按模式分叉（差异表 #20）**：**小符 = 两条整条常亮**（定值 10 档）；**大符 = 打中后两条立刻熄灭**（靶面环数保留）。与帧 [6] 无关（不查 n/5，S8 的事）；**定值点②**同 #3（`SLV_LEVEL_PROGRESS`） | `.scene`=2 | ☐ 用 10 / ☐ 改 80 |
| 7 | ALL_ON | **上 87 + 下 92 两条**整条定值 10 档；**定值点③**（`SLV_LEVEL_ALL_ON`）；**与规则图 5-23 核对**：若要求点亮更多条，记录结论改 `SLV_ALL_ON_STRIP_MASK`（差异 #6） | `.scene`=3 | ☐ 外观=规则图？ |
| 8 | 红/蓝 | 主机 SW3 切换 → **≤500ms** 内当前场景换色（红=255/10 档 R，蓝=B） | `.blue` | ☐ |
| 9 | 换色时动画 | ARMED 换色后箭头继续流动不卡相位 | `.phase` 仍动 | ☐ |

**组 4 通过判据**：1~5、8~9 全过；#3/#6/#7 三个定值/外观结论**写进表并回填 config 注释**。

---

## 五、组 5 · 5 板联机 + 烤机 + 归档（对应清单 ⑫⑬⑭）

**A. 联机防串扰**：

1. 逐块核对（板号标签=hex 文件名=宏值）——**烧错是最高频事故**；
2. 主机小符跑 3 轮：每轮**只有被点名的 1 块**进 ARMED；被击的板 `report_hit`+1，
   其余 4 块计数不动；主机流程推进正常（`g_dbg_buff_round` 递增）；
3. 大符 1 轮：两块同点、其余不动。

**B. 2h 烤机**（判据=三样都不异常）：

- 方式一（有发射机/机构）：大小符各 ~1h 真实打；
- 方式二（纯台架）：主机持续跑流程 + 人工按流程短接被点亮板（每轮 1~2 次击打节奏即可）；
- 每小时整点记一行：

| 时刻 | `g_sched_tick_cnt` | 累计 frames | 累计 report | drop×4 | 花屏/死机 |
|---|---|---|---|---|---|
| +1h | （应 +900000） | | | 恒 0 | ☐无 |
| +2h | | | | | ☐无 |

- 异常处理：**回到对应组复跑该组**，并在《清单》§六 打勾处记现象（放行规则）。

**C. 归档销项**：

- [ ] RDET9/10 定案结论：若改表 → 改 `s_hit_map[]` 一处 + 重烧对应板 + 回填清单 §五 #2；
- [ ] 10/80 三处定值 → 回填 `config_light.h`（改了就重烧验证）；
- [ ] #19 复现记录 → 清单 §五 #19 备注；
- [ ] 全部记录表照片/文件归档到本文档末尾或 `图片和附件/`；
- [ ] `DEBUG_TEST_MODE` 保持 0 出厂；确认 5 块板最终固件与板号一致；
- [ ] 《清单》§六 ①~⑭ 逐项打勾（⑤ 注明"移交 S8"）；《计划》M3 里程碑置 ✅；待办 SL5/SL9/SL10 销项。

---

## 六、通用排查速查（症状 → 先看哪个变量）

| 症状 | 第一变量 | 第二 | 根因与处置 |
|---|---|---|---|
| 啥都没反应 | `g_sched_tick_cnt` 在动吗 | — | 不动=没进 1ms 中断（断点/烧录/时钟），先回 P3 调试流程 |
| `frames` 不涨 | `bad_frames` | `s_can1_rx_drop` | 四步：frames→bad_frames→rx_drop→tick。bad=帧格式不合法（新解析比老 Decode 严：`[0]=AA`、`[1]∈{01..04}`、`[3]≤5`、`[5]≤5`，用 CAN 工具手发时照此构造；真主机必合法）；drop=没排空/过滤器；都 0=物理链路（STB H2/共地/线序） |
| 收帧正常但本机不响应 | `my_ev_seq` 涨不涨 | `g_buff_rx.panel_a/panel_b` | 不涨=**帧里没你的板号**（`SLAVE_PANEL_NUM` 烧错，回 0.2 核对） |
| 点亮了但不熄/熄得慢 | `age_ms` 是否 1~2 | `ev_cnt` 与 `state` 对应 | age 大=1ms 段被挤占；有事件不换态=状态机 bug（记录现场报修） |
| 打了不报（主机不推进） | `fire_cnt`/`armed` | `s_can1_tx_drop` | 不打错=没武装(state≠1)；报了但主机没收=发送侧（邮箱满/STB/主机 CAN1） |
| 一次击打变打错复位 | `edges`/`ignored`/`st` | 双碰间隔 | <100ms 双沿被吞是预期；>100ms 的第二沿报打错=**预期新行为**（#19/③）——确认手法再判 bug |
| **被打过的板熄灭后一直不亮 / 主机老是整体复位** | 该板 `g_dbg_slv.report_mishit` 是否在"窗口末尾打中伙伴板"后 +1 | `g_dbg_hit.st`、主机 `g_dbg_buff_state` | mishit 涨=**差异表 #22 的竞态**（已修：转态即作废在途击打）；修复后应恒 0，仅真正打暗板才涨。若 mishit 不涨仍不亮 → 查该板 `ev_cmd`/`state`（是 ARMED 但没画？还是主机没点到它） |
| **3 块板同时亮**（大符只该亮 2 块） | `g_buff_rx.imp_off` | `my_ev_seq`/`g_buff_rx.cmd` | `imp_off>0` = 熄灭帧确实漏过、**已被隐式熄灭(#21)自愈**（现象会自己消失，若频繁则查主机 `s_can1_tx_drop`）；恒 0 却仍有 3 块亮 = **板号重复**（两块板烧了同一个 `SLAVE_PANEL_NUM`）或该板 `panel_a/panel_b` 匹配异常 |
| 花屏/串色 | `g_dbg_ws_scan_idx`（调试固件） | GRB 字节序/位序 | 先用排障固件定位"哪条不亮"；颜色异常记入 #14 定值讨论 |
| Watch 变量全 0 | 符号是否在 elf | 优化等级 | 确认烧的是本次代码；volatile 已保证不被优化掉 |

---

## 七、通过标准汇总（S7 DoD，签核口径见《计划》§五）

- [ ] 组 1：frames/seq 增长、bad_frames/drop 恒 0、age_ms=1~2（⑥⑦⑪）
- [ ] 组 2：10 路环数一致、**RDET9 定案**、打错边界 7 条全过（②⑩⑥）
- [ ] 组 3：小符/大符全流程、**⑦ 旧两块确熄**、打错复位、1s 窗口第二块、**M9 未击打周期刷新**、#19 复现记录（⑨⑩⑫）
- [ ] 组 4：外观对照 5-20/5-21/5-23 通过、**10/80 三处定值**、相位 ≈1s/步（①③④⑧）
- [ ] 组 5：5 板无串扰、2h 烤机三判据、归档完成（⑫⑬⑭）
- [ ] 结论回写：计划 M3 ✅、清单 §六打勾、待办销项；**S7 全绿后开 S8（复用本台架环境）**

> 放行规则：组 1→5 **严格串行**，前组不过不开后组；组内修复后**整组复跑**。
> 关联文档：判据 ①~⑭《从机重构清单》§六 · 顺序/放行《从机代码重构计划》S7 ·
> 灯带排障《灯带白光自检与排障》 · 协议字节《从机重构清单》§七 · 硬件疑点《遗留待办》H2。
