HonestLeon/2027_Embedded_Buff/docs/遗留待办与开放问题.md

# 遗留待办与开放问题（总览）

> 单一出处：所有"还没做完 / 等确认"的事项都记在这里，完成一项就勾掉并注明结论日期。
> 分三类：**主机待办**（M*）/ **从机待办**（SL*，与从机**阶段号** S0~S8 不是一回事）/ **硬件与他人确认**（H*）。
> 最后更新：2026-10-19（从机：S0~S6 代码 ✅ + 台架实测修掉 #20/#21/#22，**S7 五组验收进行中**，进度条归 S8；
> 主机：P0~P6 ✅、与旧从机对接 ✅，剩 M1/M2/M3；2026-10 做过一次文档整理（见 R4））

---

## 一、主机（中心板）待办

| # | 事项 | 判据 / 做法 | 优先级 |
|---|---|---|---|
| M1 | **电机圈时间标定**（P5.4/P7.3b） | 小符模式实测 3 圈取平均 → 期望 **6.0 s/圈**（π/3 rad/s）。偏差则 `MOTOR_CIRCLE_NUM = 153.5 × 实测 ÷ 6.0` | 🔴 高（唯一未验证的功能项） |
| M2 | **上电时序专项**（老 bug ④ 回归验证，P7.2） | 反复"改拨码→上电" / "上电→改拨码" 各 10 次：中心灯带色序无异常（不出现紫色/不变色） | 🟡 中 |
| M3 | **烤机**（P7.3c） | 连续 2h：无花屏、无死机；`g_sched_tick_cnt` 持续增长；正常总线时 `bsp_can1/2_tx_drop_count()` 恒 0 | 🟡 中 |
| M4 | **U15（中心屏接口）** | 硬件确认是否为 3V3/GND/CLK/DIO；若是则新增 `bsp_center.c`（当前不影响功能） | 🟢 低 |
| M5 | **全亮后是否复位**（规则留白） | 已定：**保持现状**（全亮 → 2.5s → 复位 → 重新随机点亮第一组），规则未禁止 | ✅ 已定 |
| M6 | **第一块是否计时** | 已定：**不计时**（`BUFF_FIRST_HIT_TIMEOUT_EN=0`，与 2025 老固件一致）；规则字面含第一块，如赛前裁判有异议改一行 | ✅ 已定（保留开关） |<br>⚠ 本项只管**小符**；大符自 M9 起改看 `BUFF_BIG_REFRESH_EN` |
| M7 | **小符击中次数** | 已定：默认 **5 次**（按规则）；`BUFF_SMALL_HIT_COUNT=6` 可复刻老固件（老代码 `num[counter]` 越界导致实际 6 次） | ✅ 已定（保留开关） |
| M8 | **大符随机出现"同一对点两遍"** | 老算法只约束组内两块不同 → 实测相邻两轮同对 **10%**、一局平均 **0.91** 次重复。已改：`buff_random_big()` 从 C(5,2)=10 种组合里**无重复抽 5 组**（相邻/任意两轮都不同一对；同一块板仍可跨轮出现，平均出场 2 次）。开关无（要回老行为就还原函数）；主从两份 `buff.c` 共享段同步，`BUFF_BIG_PAIR_NUM` + `#error` 兜底 | ✅ 已改（2026-10-17） |
| M9 | **大符没被击打时不刷新**（点亮一对后一直没人打 → 第一对永远亮着、第二对起直接整局复位） | 已改：大符在 `BB_LIT` 每 `BUFF_BIG_REFRESH_MS`(默认 2500ms) 无击打 → **熄灭旧对 → 150ms → 点亮新一对**；语义是"换目标"不是"判失败"：**不推进 `s_round`**（进度/轮数不变）、**不复位整局**，直到任意一块被打中或打错。新一对从 10 种组合的**领用池**逐个取（`pair_take()`）→ 本局点过的每一对互不相同，池领完自动重洗且不重播当前对；刷新前先排空已到达的从机回报（避免压在周期边界上的有效击打被丢）。开关 `BUFF_BIG_REFRESH_EN=0` 即回老行为。顺带把 `buff_step()` 的"模式采样"移到"回报处理"之后（原顺序在拨码抖动那一拍会白丢一次得分）。状态机改为大符逐个领用后，预生成的 5 组数组被 `s_cur_a/s_cur_b`+池取代，`s_small[5]` 仍在 → **索引 4 越界读消失** | ✅ 已改（2026-10-17） |

> 主机功能代码 **P0~P6 已完成**；与旧从机对接测试 **已通过**。
> 已知限制（非缺陷）：与**旧从机**联调时大符"熄灭旧对"不稳定 → 旧从机 200ms 单缓冲吞掉熄灭帧，
> **新从机已修复**（S3.1 的 1ms 排空代码已落地；验证判据在 S7 组 3，见下表）。

---

## 二、从机（打符灯板）待办 —— 阶段号 S0~S8 见 `docs/从机代码重构计划.md`，本表是条目状态

| # | 事项 | 阶段 | 优先级 |
|---|---|---|---|
| SL1 | CubeMX 配置 | ✅ **已完成并校验**（6 通道 + 6 DMA 全 `MEMORY_TO_PERIPH`、10 EXTI、CAN1 1Mbps+ART/ABOM） | ✅ |
| SL2 | ~~config 从机化~~ | S1 | ✅ **已完成(2026-10-06)**：`BOARD_ROLE_MASTER=0`、`SLAVE_PANEL_NUM`(越界 #error)、灯带表 6 条 + 缓冲单点推导(实测 .bss 45.1KB)、`config_light.h` 加从机侧项、电机三文件删除并解除全部引用；语法检查 0 error 0 warning，**待 Keil Rebuild 复确认** |
| SL3 | ~~通道扫描标定~~ **✅ 无需标定(2026-10)**：硬件与 2025 相同 ⇒ 灯数(87/262/320/120/92)与"索引↔功能"映射直接继承老从机（已核对 `SLV_STRIP_*` 与老 DMA 绑定逐条一致）；逐条点亮降级为**可选排障工具**(《灯带白光自检与排障》，只能用 `DEBUG_TEST_MODE` 触发) | S2 | ✅ 已结项 |
| SL4 | ~~PB8（TIM4_CH3）是否接灯带~~ **✅ 已定**：老从机从不驱动该口 → 按老行为 `WS_LED_NUM_SPARE = 0`（不分配/不发送，省 ~4.5KB；缓冲实测 46,208B ≈ 45.1KB）；若某天确认接了灯带，改成实测灯数即可 | S2 | ✅ 已结项 |
| SL4b | **⚠ 从机板未接拨码开关**（实测）：PD2/PB3/PB4 悬空+内部上拉 → `SW_*` 恒为高（恒"激活"）。已置 `TEST_TRIGGER_USE_SW2=0`（否则一上电就永久扫描）；**颜色/大小符一律取 CAN 帧 [4]/[2]，不得用本机拨码；自检只能用 `DEBUG_TEST_MODE` 宏** | S5 | ✅ 配置已改；S5 状态机已按此实现（从机段零 `bsp_switch_get()` 引用） |
| SL5 | **RDET9 环数映射核对**（老代码 RDET9=1 环 → 2 环无对应，疑为笔误） | S7 组 2 | 🔴 `s_hit_map[]` 已按老原值落地（KEY9/10=1 环），待台架短接定案后**只改这一处表** |
| SL6 | 从机状态机 + 上报（`SLV_SLEEP/ARMED/ACTIVATED/ALL_ON`） | S5 | ✅ **代码落地(2026-10-10)**（1ms 帧转换 + 4Hz 击打/上报，`g_dbg_slv` 已交付）；台架判据 → S7 组 3 |
| SL7 | 灯板图案库（**纯复刻老从机四外观**；老代码从未画过分段进度条 → n/5 拆为 SL14/S8 专项） | S6 | ✅ **代码落地(2026-10-10)**（19 段/环数/箭头 11 份/常亮两条；`g_dbg_pat` 已交付）；外观对照 → S7 组 4 |
| SL8 | **"全激活"外观确认**（老从机只点 上/下 2 条灯带定值，需与规则图 5-23 对照） | S7 组 4 | 🟡 代码已按老口径落地（`SLV_ALL_ON_STRIP_MASK`），外观待台架核对 |
| SL9 | 5 块板联机（每块 `SLAVE_PANEL_NUM` 正确、无串扰） | S7 | 🟡 |
| SL10 | 全流程验收（小符 5 块 / 大符 5 组 / 打错复位 / 轮次切换熄灭 / 2h 烤机） | S7 | 🟡 |
| SL11 | ~~EXTI 沿收敛~~ **✅ 已落地(验收时直接改)**：`.ioc` 10 处 + `gpio.c` 2 处均改为 `GPIO_MODE_IT_FALLING`（与老从机一致）；**软件二道防线也已随 S4 落地(2026-10-10)**：`HD_IGNORE_MS=100ms` 窗内同沿忽略、表外引脚只计数不判打错、打错三条件判定 | S4 | ✅ 全部落地 |
| SL12 | **亮度位序**：老驱动 LSB-first（与 WS2812 要求相反），老固件的 `10` 实际打到灯珠是 `80`；新驱动已改为 MSB-first → 已激活态灯臂常亮/全激活若照抄 `10` 会暗 8 倍。**S7 组 4** 上板定值：复刻老观感填 `80`，按设计意图留 `10`（进度条亮度归 S8） | S6 | 🟡（`config_light.h` 的 `SLV_LEVEL_*` 已注明） |
| SL13 | **S3 物理判据已并入 S7 组 1**（不再单阶段上板）：实机看点灯/熄灭是否即时生效；判据 Watch `g_buff_rx.frames/seq/age_ms/bad_frames` + `bsp_can1_rx_drop_count()` 恒 0。**不用 CAN 盒**，发帧用真主机 | S7 | 🟡 归入 S7 |
| SL14 | **中部灯臂进度 n/5**（规则要求、老从机从未实现；**大符的"打中即熄灭"已实现**，S8 用 n/5 分段替换该熄灭分支；2026-10 根因定案：从机收 `[6]` 未渲染 + 老主机 `[6]` 靠残留）：链路已闭环，剩渲染几何（哪条/分段/亮度）须台架+机械确认 → **S8 专项**（S7 全绿后开做；对应《计划》S8、《清单》§六 ⑤） | S8 | 🟡 |

---

## 三、硬件与他人确认

| # | 事项 | 影响 | 建议问谁 |
|---|---|---|---|
| H1 | **5 块从机板的灯板号分配**（1~5 分别装在哪块板上） | 板号错 → 打符流程错乱 | 机械/电控组 |
| H2 | **TJA1044 的 STB（pin8）接法** | 若接 MCU GPIO 而没拉低 → CAN 完全不发 | 硬件 |
| H3 | **U15 四针 wafer 用途与所接引脚** | 中心屏驱动（低优先） | 硬件 |
| H4 | CAN2 电机总线波特率**实测复核**（代码依据旧生成代码已定为 1Mbps） | 电机不响应 | 电控组 / CAN 盒 |
| H5 | 从机灯带条数与机械布局（哪条是靶面/灯臂/进度条） | 图案画错条 | 机械/结构 |
| H6 | 从机是否需要 CAN2（当前保留，因 `bsp_can.c` 主从共用） | 仅影响精简度 | 内部决定 |

---

## 四、仓库与流程

| # | 事项 | 说明 |
|---|---|---|
| R1 | **推送 git** | ✅ **已完成(2026-10-17)**：`git push origin main` 推到 `HonestLeon/2027_Embedded_Buff`(PUBLIC)。以后要推就现查 `git rev-list --count origin/main..HEAD`，别在本文件记数字 |
| R2 | 文档母版与副本 | ✅ **已定并执行（2026-10-06）**：`docs/` 为唯一母版。上级目录的 7 份副本 + `大符思路.txt` 重复份已删除（均等于或旧于 `docs/`，且 `docs/` 那份在 git 里）；上级目录只保留第三方教程《CubeMX基础配置》(+zip)、`图片和附件/`、`原理图/` 导出与架构图 HTML |
| R3 | 从机工程改名 | ✅ **已定：不改名**。`2027_Embedded_Buff_Slave/` 内部的 `.ioc`/Keil 工程名沿用 `2027_Embedded_Buff_Master`，属预期状态；**不要**因此重跑 CubeMX 的 Project Name（会连带重生 `MDK-ARM/` 并需要重配 Groups/包含路径）。区分主从看**目录名**与固件里的 `BOARD_ROLE_MASTER` |
| R4 | 文档整理（合并与瘦身） | ✅ **已完成（2026-10-19）**：五份已结项/互相重复的文档合并为两份 —— 《CubeMX裁剪说明》+《P3调试指南》+《从机CubeMX操作说明》→ **《CubeMX校验与踩坑》**（生成后必查清单 + 关键数值速查 + 三个坑 + 寄存器判定表）；《白光测试指南》+《从机灯带自检与排障》→ **《灯带白光自检与排障》**（主从通用）。《代码重构计划》由 192 行打卡记录压成 45 行决策与踩坑（过程在 git 历史里）；《主机CubeMX配置清单》删掉 18 处指向仓库外 `图片和附件/` 的死链截图；NVIC 表里 CAN2_RX0 的优先级按 `.ioc` 更正为 **1/0**（旧文档写 1/1 是笔误）。全部交叉引用已同步 |

---

## 五、完成即销项

- 每完成一项：在本文件把 `⬜` 改成 `✅ 已完成(日期)` 并附一句结论（例：`M1 ✅ 2026-10-08 实测 6.1s/圈, CIRCLE_NUM 153.5→156.3`）；
- 相关明细仍在各自文档（主机看《主机CubeMX配置清单》0.3 节；从机看《从机代码重构计划》与《从机重构清单》）；
  本文件只做"总览与状态"，避免多处分叉。
