HonestLeon/2027_Embedded_Buff/docs/从机重构清单.md

# 从机（打符灯板）重构清单 —— 详细版

> **实施路线图**：见 `docs/从机代码重构计划.md`（阶段 S0~S8、里程碑、风险、DoD）。
> **CubeMX 配置**：配置值的依据见 `docs/主机CubeMX配置清单.md`（从机差异见其 0.1 节），改完怎么校验见
> `docs/CubeMX校验与踩坑.md`（含从机期望值：6 条 DMA 全 `MEMORY_TO_PERIPH`、10 路 KEY）——**已校验通过**，结论见下节。
>
> 目标：在 `2027_Embedded_Buff_Slave/`（主机 P3 快照）基础上，重构出从机固件。
> 依据：**2026 规则**（`docs/能量机关规则.pdf` 5.5.2.1）+ **2025 老从机固件逐行分析** + 主从协议。
> 架构：与主机同构（`config` / `bsp` / `application`），**去掉 motor**，新增 `hit_detect`。

---

## 一、从机要干什么（一句话拆解）

```
收 CAN(0x161) ──► 按灯板号判断是否与我有关 ──► 切状态
      │                                            │
      │                                    ① 休眠(全灭)    state 1
      │                                    ② 待激活(特殊灯效+箭头流动) state 2
      │                                    ③ 已激活(环数显示+灯臂全亮)   state 3
      │                                    ④ 全激活(全亮)             state 4
      ▼
弹丸击打(EXTI ×10) ──► 判环数 ──► 上报 CAN(0x160) 或 上报"打错复位"
```

---

## 二、CubeMX 改动清单 —— ✅ 已完成并校验（2026-10）

**校验结论（逐项通过）**：

| 检查项 | 结果 |
|---|---|
| 外设 | CAN1 / CAN2 / DMA / NVIC / RCC / RNG / SYS / **TIM3 / TIM4** / TIM6 ✓ |
| DMA 请求 | 6 条：`TIM3_CH1/TRIG`、`TIM3_CH2`、`TIM3_CH4/UP`、`TIM4_CH1`、`TIM4_CH2`、`TIM4_CH3` ✓ |
| **DMA 方向** | **6 条全部 `DMA_MEMORY_TO_PERIPH`** ✅（最关键项） |
| LINKDMA | CC1/CC2/CC3/CC4/TRIGGER/UPDATE 共 6 条 ✓ |
| GPIO 复用 | PA6/PA7/PB1（TIM3）+ PB6/PB7/PB8（TIM4）= 6 通道 ✓ |
| PWM 通道 | 6 个 `HAL_TIM_PWM_ConfigChannel` ✓ |
| NVIC | CAN1=1/0、CAN2=1/0、TIM6=2/0、**EXTI×6=3/0**、**DMA×6=5/0**、SysTick=15/0，分组 GROUP_4 ✓ |
| CAN1 位率 | **1Mbps**（P=3/BS1=10TQ/BS2=3TQ）✓，且 `AutoRetransmission`/`AutoBusOff` = **ENABLE**（本次改动）✓ |
| CAN2 | 保留（100kbps，从机不用但 `bsp_can.c` 主从共用）✓ |
| 中断入口 | 6 EXTI + 6 DMA + CAN1_RX0 + CAN2_RX0 + TIM6_DAC ✓ |
| KEY 宏 | `KEY1~KEY10` 共 10 个 ✓，全部 No-pull ✓；**触发沿已从双边沿收敛为下降沿**（`IT_FALLING`，与老从机一致，验收时修正 —— 见 S4 硬约束第 1 条） |
| USER CODE | `it.c` 调度器（`g_sched_tick_cnt`/`HAL_TIM_PeriodElapsedCallback`）与 `main.c` 初始化序列均保留 ✓ |

> **为什么生成代码里本来就带着 TIM4/EXTI**：从机模板取自**主机裁剪之前**的快照，
> 因此 `Core/` 下生成代码从一开始就是"全量版"；本次 CubeMX 只改了 `can.c` 的 ART/ABOM 两项
> （`.ioc` 新增 `NART/ABOM`）。`.ioc` 与生成代码现在完全一致。

原逐项操作清单（引脚表/通道表/DMA 流表/NVIC/CAN 位率）已并入《主机CubeMX配置清单.md》与《CubeMX校验与踩坑.md》，
本文不再重复维护；那里还多出两条本文没有的坑：PB8 先配但 `led_num` 填 0、
PB8 与 CAN1/BOARD_ID 复用脚冲突（步骤 3）。**要回查 CubeMX 怎么点的，直接看那份。**

### 仅剩的两条从机口径（S1/S2 会用到）

| 项 | 值 |
|---|---|
| 灯带老口径（**✅ 直接继承，硬件与 2025 相同**） | 87(上) / 262(靶面) / 320(灯臂) / 120(侧灯臂) / 92(下)；PB8 按老行为不驱动(填0) |
| 通道 ↔ 老 `LED_ROAD_n` | PA6=3(上) PA7=2(中) PB1=4(灯臂) PB6=5(侧灯臂) PB7=1(下) PB8=从未驱动 |
| 索引 5(PB8) | 已定案 `WS_LED_NUM_SPARE = 0u`：老从机从不驱动该口，硬件与 2025 相同 ⇒ 不驱动即事实（不分配缓冲/不发送）|

---

## 三、代码改动清单（逐文件）

### 3.1 `config/config_board.h` —— ✅ 已完成（S1，2026-10-06）

```c
#define BOARD_ROLE_MASTER    0      /* 从机构建 */
#define SLAVE_PANEL_NUM      1u     /* ⚠ 每块板烧录前改这一处(1~5)，越界直接 #error */
#define TEST_TRIGGER_USE_SW2 0      /* ⚠ 本板未接拨码 → SW 触发不可用(悬空恒高会一上电永久扫描);
                                       自检只能用 DEBUG_TEST_MODE=1 编调试固件(见计划总体策略 #5) */
```
- 拨码极性沿用实测结论（`*_ACTIVE_LEVEL = 1`：OFF/下=低、ON/上=高）；
- `SLAVE_PANEL_NUM` 取代老 `#define BUFF_NUM 3`：`#if` 越界检查（填 0 或 >5 就编译不过，
  防"板号写错导致本机永不点亮"），并要求**固件文件名带板号**（Keil Options→Output→
  Name for Executable），联机前逐块核对（§六 ⑫）；
- 与主机同名文件的差异**仅限**角色 / 板号 / SW2 语义 / 注释，其余保持一致以便 diff 比对。

### 3.2 `config/config_ws2812.h` + `bsp/bsp_ws2812.c` —— ✅ 完成（灯数继承老从机口径，无需实测）

灯数**只定义一次**，灯带表与 DMA 缓冲都由它推导 —— 根治"改了表忘了改缓冲"的越界：

```c
/* config_ws2812.h：口径直接继承老从机(硬件未变)，无需实测标定 */
#define WS_LED_NUM_UP         87u   /* 索引0 TIM3_CH1/PA6  老 LED_ROAD_3 上   */
#define WS_LED_NUM_TARGET    262u   /* 索引1 TIM3_CH2/PA7  老 LED_ROAD_2 中(靶面) */
#define WS_LED_NUM_ARM       320u   /* 索引2 TIM3_CH4/PB1  老 LED_ROAD_4 灯臂 */
#define WS_LED_NUM_ARM_SIDE  120u   /* 索引3 TIM4_CH1/PB6  老 LED_ROAD_5 侧灯臂 */
#define WS_LED_NUM_DOWN       92u   /* 索引4 TIM4_CH2/PB7  老 LED_ROAD_1 下   */
#define WS_LED_NUM_SPARE       0u   /* 索引5 TIM4_CH3/PB8  待核实是否接灯带   */
#define WS2812_STRIP_TBL { {&htim3,TIM_CHANNEL_1,WS_LED_NUM_UP}, ... }  /* 6 行 */
#define WS2812_STRIP_NUM     6u
```

RAM 实测（`arm-none-eabi-size` 量 `.bss`，S1 完成时）：**46,208 B ≈ 45.1KB**（老口径 881 颗；索引5=PB8 置 0 后只剩占位 3B）。
数据区共 128KB（Keil 按 Target 对话框生成的 scatter = `RW_IRAM1` 0x20000000/112KB +
`RW_IRAM2` 0x2001C000/16KB），**CCM(0x10000000) 根本不在数据区里** → 静态缓冲不可能落到
DMA 访问不到的 CCM，这条原先靠"记得别放 CCM"的口头约束可以撤销（S2 若把灯数往上改，
留意 881 颗这一档还有约 78KB 余量）。

> **灯数与映射不需要标定**（S2 已重定义为口径继承）。逐条点亮只是**排障工具**，见 [`灯带白光自检与排障.md`](灯带白光自检与排障.md)：
> 只在“某条不亮 / 段位不对 / 改过接线”时用它定位。⚠ 本板未接拨码，**只能用 `DEBUG_TEST_MODE=1` 编译期触发**"索引 ↔ 物理位置"对照表并回填上面的宏。
> （`SW2=ON` 那套触发在从机不可用）。仅当实测与老口径不符时，才回填 `WS_LED_NUM_*`。

### 3.3 `application/buff.c`（**换掉状态机段** —— ✅ S5 已落地 2026-10-10）

保留（主从共享的真相源，**逐字节别改**）：
- `buff_frame_pack/parse`、`buff_send_frame`、`buff_slave_report_parse`、`buff_random_small/big`

替换（文件头已标注"主机构建专用"的那一段）为**从机状态机**：

| 状态 | 显示 | 行为 |
|---|---|---|
| `SLV_SLEEP`（老 state 1） | 5 条全灭 | 收到 `0x01` / `0x03` 进入；进入时**清 `once`**（重新武装击打） |
| `SLV_ARMED`（老 state 2） | 待激活图案 + 灯臂箭头流动 | 收到 `0x02` 进入；**只有此状态允许被击中** |
| 转态清空（差异表 #22） | `slv_enter()` 首次行动 = `hit_detect_flush()`；`buff_step()` 只在 `s_slv==SLV_ARMED` 时接受 HIT（否则计 `stale_hit` 丢弃） | 防止"熄灭后才被消费的旧击打记录"把状态机拉回 ACTIVATED 或误报打错（后者会让主机整体复位） |
| `SLV_ACTIVATED`（老 state 3） | 环数显示 + 灯臂处理**按模式分叉**：小符 = 整条常亮(老效果)；大符 = **打中后灯臂熄灭**(`[2]`→`light_set_big`，差异表 #20) | 被击中时进入；**进入瞬间上报 `0x03`**（一条，不重复发）；n/5 进度条移 S8 |
| `SLV_ALL_ON`（老 state 4） | 全激活外观 | 收到 `0x04` 进入（**不需匹配灯板号**） |

解码规则（老 `Decode()` 的等价物，注意两个细节）：
```c
if ([0] != 0xaa) return;
/* ① 0x03(复位) 与 0x04(全亮) 不看灯板号; 0x01/0x02 必须 [3]==BUFF_NUM || [5]==BUFF_NUM */
/* ② 大小符/颜色/round 每帧都更新: [2]→大小符, [4]→红蓝, [6]→round(已激活组数, 供进度显示) */
```

### 3.4 `application/hit_detect.c/.h`（**新增 · ✅ S4 已落地 2026-10-10**）

老 `gpio.c` 的 EXTI 回调 → 拆成"中断只记录 + 逻辑帧判定"，并把老代码的隐式标志显式化：

```c
/* 引脚→环数 标定表(2025 老代码口径; ⚠ RDET9/10 仍需台架短接核对, 见第五节 —— 机械映射不受硬件未变影响) */
static const struct { uint16_t pin; GPIO_TypeDef *port; uint8_t circle; } hit_map[] = {
    { KEY1_Pin,  KEY1_GPIO_Port, 10 }, ... { KEY8_Pin,  KEY8_GPIO_Port,  3 },
    { KEY9_Pin,  KEY9_GPIO_Port,  1 },     /* ⚠ 老代码写的 1(疑为 2) */
    { KEY10_Pin, KEY10_GPIO_Port, 1 },
};

typedef enum { HD_ARMED, HD_FIRED, HD_LOCKED, HD_MISHIT } hd_state_t;
void hit_detect_on_exti(uint16_t pin);   /* EXTI 回调里调: 只记时间戳+置位 */
void hit_detect_task(void);              /* 4Hz: 查表判定 → 通知 buff 状态机 */
```

老代码的三个隐式机制要保留其**语义**（实现必须换，见下面的硬约束）：
- `once` 三态：`0`=可击发 → `1`=已击发 → `2`=打错(要上报复位)，**进入休眠状态时清零**（= 重新武装）；
- `start` + `start_countt`：老代码在**任意一个沿**之后把 EXTI 整体锁死约 2 个主循环(≈400ms)，
  期间所有后续沿只清标志不判定 —— 它同时干了两件事：①吞掉同一次击打的抖动/回弹，
  ②也顺带吞掉了别的板的击打；
- **打错 = 中断发生在非 `once==0 && state==2` 条件**（打已激活的板、或休眠状态被击）→ 上报 `[2]=0x01` 并回休眠。

#### ⚠️ S4 的三条硬约束（不遵守就会把一次正常击打变成"打错复位"，整轮被清）

1. **沿数不一致（已修正）**：老从机 10 路是 `GPIO_MODE_IT_FALLING`（只下降沿），而本工程最初
   误配成 `RISING_FALLING` 双边沿 → 同一次击打产生 2 个沿（击打 + 回弹），第二个沿到达时
   `HD_ARMED → HD_FIRED` 已发生，照第 3 条字面判定就会被判"打错"→ 上报 `[2]=0x01` → 主机整轮复位。
   ✅ **已落地**：`.ioc`（10 处 `GPIO_ModeDefaultEXTI`）与 `gpio.c`（2 处）均改为 `GPIO_MODE_IT_FALLING`
   （依据：老固件整季验证；两者一起改，重新生成也一致）。
   ➕ **仍建议**在软件里保留 `HD_IGNORE_MS`（50~100ms）窗内忽略同一引脚的后续沿，作为二道防线。
2. **未匹配引脚的杂散中断不得判打错**：老 `HAL_GPIO_EXTI_Callback` 的 `else` 分支是
   "任何没落进 10 个 KEY 判断的回调 → `once=2`"（`EXTI9_5` 一次给 5 个线号都调一遍回调，
   多余的那几次全靠引脚比较兜住）→ 新实现里 `pin` 不在 `hit_map[]` 内时**只清标志直接返回**。
3. **打错要能区分"同一次击打的后续沿"与"真打错"**：落地判据 = 状态非 `HD_ARMED`（或已击发）
   **且** 距上一沿 > `HD_IGNORE_MS` —— **超窗任何引脚都算打错**，窗内一律吞（同引脚回弹与
   相邻电极抖动都是杂散沿）。这与老代码"锁存期外从不看引脚、一律判打错"的语义一致。
   ⚠ 2026-10-10 验收修正：初版曾把"引脚≠上次击发引脚"设为**永久**条件 —— 后果是同一环的
   再击打永远判不进打错（台架⑩"已激活的板再被打同一环"将无上报），已移除；引脚信息仍记
   `g_dbg_hit.last_pin` 供观测。另：老 `start` 锁存 ≈400ms，新窗 100ms，**100~400ms 区间的
   第二环真击新会判打错、老被吞**（见差异表 #19）；⑩ 必须专门打"已激活的板"与"休眠的板"各一次。

另外：老代码从击发到上报走的是"主循环 200ms 一轮"，上报最快也要 0~200ms；新架构里
判定放在 4Hz 逻辑帧 → 上报最坏延迟 250ms，**比老代码还慢**。若台架发现主机响应迟钝，
把 `hit_detect_task()` 挪进 1ms 节拍（判定本身只有几个变量比较，开销可忽略）。

### 3.5 `application/light.c`（**图案库 · ✅ S6 已落地 2026-10-10，纯复刻口径**）

老 `WS2812.c` 的图案函数搬过来，**标定数值一个字都别改**（逐颗数出来的）：

> ⚠ **搬哪一份老文件**：老 `master/Divice/WS2812.c` 与老 `slave/Divice/WS2812.c` **同名但内容不同**，
> 只有**从机那份**是灯板图案的真相源。已核对出的差异：老主机版 `Buff_Arrowhead` 把入参丢掉、
> 硬编码 `(10,0,0)`（只有红、无蓝）；老主机版箭头流动画 9 次叠加(偏移 0~32)、从机版 11 次(0~40)；
> 老主机版 `Buff_Activatable` 只传 `Red,0,0`（蓝通道被丢），从机版传 `Red,0,Blue`；
> 灯数也不同（老主机 `_3=88/_4=256`，老从机 `_3=87/_4=320/_5=120`）。**不要拿主机那份的数值来"纠正"从机**。

| 图案 | 老函数（从机那份） | 说明 |
|---|---|---|
| 待激活靶面 | `Buff_Activatable(Red,Blue)` | **19 段**标定（老注释/文档写 20 段，以 `config_light.h` 的 `LIGHT_ARMED_SEGS` 条目数为准），画在老 `LED_ROAD_2` |
| 灯臂箭头流动 | `Buff_Arrowhead_Flowing(&enable,R,B)` | **6 行**模板 + 内部相位，画在老 `LED_ROAD_4`；老代码 11 次叠加(偏移 0~40)，别数错次数 |
| 环数显示 | `Buff_Activating(circle)` | `LIGHT_RING_MAP` 10 组 {起始,长度}；红/蓝两张表**几何完全相同** → 新实现用一张表 + 颜色入参即可 |
| 全激活 | 老 state 4 只点了 2 条(值 10) | ⚠ 需确认已激活外观（规则图 5-23）；值 10 的实际观感见下面"亮度位序"一条 |
| 进度条(已激活态灯臂) | ARM(320)+ARM_SIDE(120)：老代码 = **两条整条全亮(定值 10)**，与 `[6]` 无关；且大小符不分叉 | 小符 = 复刻两条全亮；**大符 = 打中即熄灭**(差异表 #20，规则语义，2026-10 定案)；n/5 分段点亮 = 新增功能，**移 S8 专项**（旧根因/新链路见《从机代码重构计划》S8） |

**动画节拍必须对上老代码的观感**：老从机主循环 ≈200ms 一圈，`i` 数到 4 才让箭头走一步
→ **每步约 800ms~1s**。新架构 4Hz 逻辑帧(250ms) 若每帧走一步，箭头会比老代码**快 4 倍**；
S6 实现时要按"每 4 个逻辑帧步进一次"（与老观感一致），台架 ③ 项对照着看。

**亮度换算（2026-10-10 验收修正版，逐行核对老 `main.c`+`WS2812.c`）**：
老在用的函数（`Buff_Activatable`/`Buff_Arrowhead(_Flowing)`/`Buff_Activating`）**不做阈值化**，入参
直接写灯珠；">0→255" 只存在于从未被从机调用的死代码（`Buff_Unactivated_*`/`Buff_Heart` 等），
**别拿它当依据**。按调用点分两档：

| 档 | 老出处 | 观感 |
|---|---|---|
| **255** | `Buff_Activatable(255,0)/(0,255)` 靶面 19 段；`Buff_Activating` 内部写死 255 环数段 | 位序无关 |
| **10** | `Buff_Arrowhead_Flowing(&t,10,0)/(0,10)` **箭头**；state3 ROAD_4/5 **灯臂两条常亮**；state4 ROAD_1/3 **全激活** | 老 LSB-first 实际≈**80**（位序陷阱三处） |

新实现三处"10"分别走 `SLV_LEVEL_ARROW / SLV_LEVEL_PROGRESS / SLV_LEVEL_ALL_ON`（config 一处改，
可分档也可统一），10/80 观感定值归 **S7 组 4** 台架拍板（差异 #14 / 待办 SL12）。

### 3.6 调度（`Core/Src/stm32f4xx_it.c`，沿用主机模板）

> ✅ **S3.1 已落地(2026-10-06)**：`it.c` 的 1ms 段现为 `buff_can_rx_poll()` → `bsp_ws2812_refresh_all()` → `buff_tick()`；
> ✅ **S4/S5 接线已落地(2026-10-10)**：1ms 的 `buff_tick()` = 消费 `my_ev_*` 锁存做帧触发的状态转换；
> 4Hz 帧顺序 = `hit_detect_task()` → `buff_step()`（击打事件+上报+颜色）→ `light_tick()`（图案/白光自检）。
拨码 20ms 采样保留但与主机同构（**业务不得读 `SW_*`**，本板未接拨码）。
主机状态机段在从机构建里由 `#if BOARD_ROLE_MASTER` 关闭 → **从机只收不发**，不会与真主机抢 `0x161`。

```c
/* 1ms: */
motor_*                        → 删除（从机无电机）
hit_detect_task();             /* 击打判定(或放 4Hz) */
bsp_can1 排空 → 解码 → 状态   /* ⚠ 见第四节: 必须 1ms 级, 不能等 4Hz */
bsp_ws2812_refresh_all();
/* 4Hz: */
从机状态机抬升/灯效动画 + light_tick() + 上报
```

### 3.7 Keil 工程（✅ S4 已完成）

`application` Group：✅ 已加 `hit_detect.c`、已删 `motor.c`（`.uvprojx`/`.uvoptx` 同步）；`bsp` Group 不变；Include Paths 不变。

---

## 四、⚠️ 协议时序要求（从机必须满足，否则功能静默失效）

| 场景 | 主机发帧 | 间隔 | 要求 |
|---|---|---|---|
| 大符轮次切换 | 先 `0x01`(熄灭旧对) → 再 `0x02`(点亮新对) | **150ms** | **从机必须 1ms 级排空 CAN**，两帧都要看到；否则熄灭帧被后一帧覆盖 → 旧灯板不熄（老从机 200ms 单缓冲的固有缺陷，实测表现为"熄灭不稳定/一开始不熄灭"） |
| 打错复位 | `0x160` 上报 `[2]=0x01` | — | 主机侧"复位优先"判定，从机如实上报即可 |
| 规则上限 | "重新点亮前灯效熄灭至多 200ms" | — | 主机已取 150ms，从机不得引入额外延迟（如 200ms 阻塞） |

**结论**：从机把 `bsp_can1_pop()` 放 **1ms 节拍**里排空（只做"收帧→更新目标状态/置事件"），
灯效与状态机放 4Hz 逻辑帧。**禁止 `HAL_Delay(200)` 之类的阻塞**（老从机就是这么写的）。

---

## 五、与老从机的差异（有意修正 / 待核对）

| # | 项 | 老从机 | 新从机 | 类型 |
|---|---|---|---|---|
| 1 | 中部灯臂进度 n/5 | **未实现**：老代码不分模式、两条整条全亮(定值 10)，`[6]` 存了 `counter` 却从未用于渲染；老主机复位/全亮帧 `[6]` 还靠字节残留 | 小符复刻两条全亮；**大符打中即熄灭**(差异表 #20)；n/5 分段点亮**移 S8 专项** | ✅ 已定案（大符熄灭 + S8 新增） |
| 2 | 环数映射 RDET9 | 老代码 = **1 环**（RDET8=3、RDET10=1 → **2 环无对应**） | 待实测：RDET9 是否应为 2 环 | ⚠ **必须台架点数核对** |
| 3 | `once`/`start`/`start_countt` | 三个隐式标志 + 时间锁存 | 显式 `HD_*` 状态 | ✅ 可读性 |
| 4 | 主循环 `HAL_Delay(200)` | 阻塞 200ms（CAN 响应与灯效都卡） | TIM6 1ms 调度 + 4Hz 帧 | ✅ 架构升级 |
| 5 | 灯效实现 | 直接改 CCR 数组 + 每圈 5 路 `Start_DMA` | RGB 逻辑缓冲 + dirty/busy | ✅ 与主机同构 |
| 6 | 全激活(state 4) 外观 | 只点亮 2 条（值 10） | 待确认（规则图 5-23） | ⚠ 需与规则图核对 |
| 7 | `BUFF_NUM` 灯板号 | `#define BUFF_NUM 3`（每块板单独编译） | **决定：沿用"按板编译"** → 做成 `config_board.h` 的 `SLAVE_PANEL_NUM`(1~5)，每块板烧录前改一处；固件文件名带板号避免烧错 | ✅ 已定 |
| 8 | 上报帧字节完整性 | 打错帧只写 `[0]=AA`、`[2]=0x01`，`[1]`/`[3]` **残留上一次击中帧的 `0x03` 与板号** | 新从机**每次四个字节全写**：击中 `[1]=0x03 [2]=0x00 [3]=板号`；打错 `[1]=0x00 [2]=0x01 [3]=板号` | ✅ 有意修正（主机"复位优先"两种都能兼容，但别再依赖残留值） |
| 9 | 环数是否上报 | `circle_num` 只做本地显示，**从不发给主机** | 同样不报（上行帧没有环数字段） | ✅ 一致；要报环数得两端一起改协议 |
| 10 | 一次激活里第二块板被打 | `start` 的 ≈400ms 全局锁存会**吞掉另一块板的击打**（不上报） | 新按"引脚 + 时间窗"区分，第二块能正常上报（主机 1s 窗口内不推进，行为不变） | ⚠ 待台架 ⑨ 验证 |
| 11 | `Decode` 不检查板号的字段 | `[1]==0x03/0x04`、`[2]` 大小符、`[4]` 颜色、`[6]` 计数 **对所有板生效** → A 板的帧会改 B 板的状态 | 复刻该语义（主机每轮对 5 块板都发同样的大小符/颜色/round，实测无害） | ✅ 一致（这是老行为，别"顺手修成"看板号） |
| 12 | 全激活(state 4) 清屏 | 老 state 4 **不更新 `last_state`** → 4→2 转换不触发清屏，可能残留上一次的环数图案 | 新 `SLV_*` 每次状态转换统一清屏（等价于把 `last_state` 收敛进 `goto`） | ✅ 有意修正 |
| 13 | 灯带数来源 | 老**主机**工程 `_3=88/_4=256`；老**从机**工程 `_3=87/_4=320/_5=120`（同名不同值） | 新从机取从机那份 = 87/262/320/120/92（`config_ws2812.h`） | ✅ 来源正确；⚠ 不要拿主机值来"纠正" |
| 14 | WS2812 位序 | **低位先出（LSB-first）**，与协议要求相反；因全代码只用 0/255 才没暴露 | 新驱动高位先行（正确）→ 中间值亮度会变（`10` 老实际≈`80`） | ⚠ **必须台架定值**（见 `SLV_LEVEL_*` 注释 / 待办 SL12） |
| 15 | 复位段 | `WS2812_Reset_NUM=50` bit ≈62.5µs（勉强过 50µs 规格） | 90 bit ≈112µs | ✅ 有意加强 |
| 16 | 图案越界 | `Buff_Arrowhead` 只判起始索引 `>=0 && <LED_NUM_4`，`start+count` 可越界 | `bsp_ws2812_set_rgb()` 统一校验 `start+count <= led_num`，越界直接不写 | ✅ 有意加强 |
| 17 | CCR 缓冲宽度 | `uint16_t[]` 强转 `(uint32_t*)` 传 HAL，靠 DMA HALFWORD 对齐才正确 | 同为 `uint16_t` + HALFWORD，语义未变 | ✅ 一致（**别改元素宽度**，会静默改坏时序） |
| 18 | **击打输入触发沿** | 10 路全部 `GPIO_MODE_IT_FALLING` + NOPULL（只吃下降沿） | ✅ 已同步改为 `IT_FALLING`（`.ioc` 10 处 + `gpio.c` 2 处，一起改故重新生成也不会回退）；S4 仍保留 `HD_IGNORE_MS` 作二道防线 | ✅ 已一致（详见 §3.4 / 待办 SL11） |
| 19 | **击打判定时间窗** | `start` 把 EXTI 判定整体锁存 ≈2 个主循环(**≈400ms**)，窗内**一律**吞（含同板第二次真击；且锁存外打错**从不看引脚**） | `HD_IGNORE_MS=100ms`：窗内一律吞、超窗任何引脚都判打错；HIT 事件待 4Hz 消费期间(≤250ms)新打错暂存 `ev_lost` → 实际保护 ≈100+250ms。**100~400ms 区间的第二环真击：新判打错→复位整轮，老被吞** | ⚠ 台架 ⑨/⑩ 留意（S7 组 3）；若赛场误复位，加大窗一处即回老保护强度（config_buff.h） |

| 20 | **大符打中后灯臂处理** | 老 state3 对 `ROAD_4`+`ROAD_5` **一律整条常亮**(10 档)，大符小符不分叉 → 被打中的那一块外观与"未打中"的伙伴无差别 | **按模式分叉**(2026-10 用户定案): 大符 = 打中后**灯臂两组立刻熄灭**(该灯臂已完成，另一块由主机熄灭帧处理)；小符 = 保持老效果常亮。`light_set_big()` 每 4Hz 刷 `[2]`，渲染在 `draw_activated()` | ⚠ 有意修正（规则语义）; 进度 n/5(S8) 届时替换大符的熄灭分支 |

| 21 | **点亮帧的"隐式熄灭"** | 老 `Decode()` 只按板号匹配：不在 `[3]/[5]` 里的板**什么都不做**（保持原状态）。若熄灭帧丢失，该板就一直亮着 → 台架实测过"**3 块板同时亮**" | **大符**下收到点亮帧(`0x02`)而本板不在 `[3]/[5]` 里 → 按熄灭处理（回 `SLV_SLEEP`）。熄灭帧丢了也能在下一轮点亮时自愈；**小符不加**（打过的板要保持亮环数）。计数 `g_buff_rx.imp_off`：仅"确实还亮着被清掉"时 +1，正常轮次恒 0（= >0 说明真丢过熄灭帧） | ✅ 有意加强（脆弱点消除） |

| 22 | **转态与在途击打** | 老代码同款竞态：EXTI 中断里置 `once=1`，主循环(≈200ms)才消费；期间状态若被帧改掉，旧记录会被按**新状态**判定 | **转态即作废**(`hit_detect_flush()`) + 消费前校验 `s_slv==SLV_ARMED`（陈旧事件计 `stale_hit`）。**台架实测症状**：大符伙伴板在 1s 窗口末尾被打中 → 熄灭帧先到(1ms) → 旧记录在 4Hz 被判成"打错" → 上报 → 主机整体复位并重生成序列 → 该板看起来"熄灭后一直不亮"。修复前该路径**必然**触发（记录跨度最长 250ms） | ✅ 有意修正（真 bug） |

**核查结论（2026-10-10 复核，逐行对照老从机 `main.c`/`gpio.c`/`bsp_can.c`/`Divice/WS2812.c`；
S4~S6 验收修正：#14 受影响处补"箭头"、打错判据去掉永久"引脚≠"排除、新增 #19）**：
新从机与老从机在**功能语义上等价** 9 项（#9/#11/#13/#15/#17 等），**有意加强或修正** 6 项
（#3 #4 #5 #8 #12 #16），**必须上台架才能定案** 5 项 = #2 环数 RDET9、#10 第二块板上报、
**#14 亮度位序（箭头/灯臂常亮/全激活三处"10"）**、**#18 EXTI 沿**、**#19 击打时间窗 100~400ms 区间**；
另有规则要求而老代码没做的 #6 全激活外观——代码已按老口径实现，待台架与规则图对照；
**#1 进度条已定案**：S4~S6 复刻老观感（两条全亮），n/5 新增功能移 S8 专项
（旧根因与新链路结论见《从机代码重构计划》S8）。

---

## 六、S7 台架总验收清单（**唯一一次上板**，覆盖 S3~S6 全部物理判据）

> **判据只有两种手段：实机观察 + 调试器 Watch 全局变量/结构体**（`g_sched_tick_cnt`、`g_buff_rx`、
> `g_dbg_hit`、`g_dbg_slv`、`g_dbg_pat`、`bsp_can1_rx_drop_count()`）。**不使用 CAN 分析仪/CAN 盒**；
> 发帧一律用真主机（或 5 板互连）。执行顺序与放行规则见《从机代码重构计划》S7（组 1 收帧 → 组 2 击打
> → 组 3 状态机 → 组 4 外观 → 组 5 联机/烤机收尾，前组不过不开后组）。
> **本节是判据；具体每一步怎么操作、Watch 期望值、记录表与故障树见 [`从机S7台架测试指南.md`](从机S7台架测试指南.md)。**

- [ ] **① 灯带自检（可选，S7 组 4 前）**：仅当某条不亮/段位不对时用 —— `DEBUG_TEST_MODE=1` 编调试固件 → 逐条白光各 2s → Watch `g_dbg_ws_scan_idx`（见 [`灯带白光自检与排障.md`](灯带白光自检与排障.md)）。**口径已继承老从机，无需标定**
- [ ] **② 环数映射核对**（S7 组 2）：逐一短接 RDET1~10，记录实际点亮/上报的环数（重点核对 RDET9/10）
- [ ] **③ 待激活外观**：特殊灯效 + 灯臂箭头流动，与规则图 5-20 对照
- [ ] **④ 环数显示**：打到 10/9/…/1 环，显示段与 `LIGHT_RING_MAP` 一致（1 环的分段显示已特殊处理）
- [ ] **⑤ 进度条**（**移 S8 验收，S7 不查此项**）：大符下从机中部灯臂按 `round` 显示 n/5（0/5 → 5/5）—— S8 专项实现与验收（旧根因：老从机收了 `[6]` 从未渲染 + 老主机复位/全亮帧 `[6]` 靠残留；结论见《从机代码重构计划》S8）
- [ ] **⑥ 上报**：被击中后**只发一次** `0x03 + 自己灯板号`；打错时发 `[2]=0x01`
- [ ] **⑦ 熄灭**（S7 组 3，最关键）（关键）：大符轮次切换时，旧的两块**确实熄灭**（用主机 + 新从机联调验证）
- [ ] **⑧ 全激活外观**：收到 `0x04` 后与规则图 5-23 对照
- [ ] **⑨ 与主机全流程**（S7 组 3）：小符 5 块（含"打错复位"）、大符 5 组（含 1s 窗口内打/不打第二块）
- [ ] **⑩ 边界**：休眠状态下被击（应上报打错复位）、已激活状态被击（同上）、复位帧 `0x03` 全局生效
- [ ] **⑪ 时序（归 S7 组 1）**：Watch `g_buff_rx.age_ms` 在持续发帧时稳定 1~2（=1ms 排空节奏），
- [ ] **⑫ 5 块板联机（S7 组 5）**：每块 `SLAVE_PANEL_NUM` 正确、同总线同时在线互不串扰（固件文件名带板号逐块核对）
- [ ] **⑬ 烤机（S7 组 5）**：连续 2h 无死机/无花屏，`g_sched_tick_cnt` 持续增长，CAN 收发 drop 计数恒 0
- [ ] **⑭ 归档**：环数标定表(S4 实测)与自检记录（若做过）回填文档；出厂前确认 `DEBUG_TEST_MODE=0`

---

### 6.1 灯带自检 / 排障记录表（可选，仅异常时填）

> 📖 **本表仅作排障记录**：硬件与 2025 相同 ⇒ 灯数与映射已继承老从机，**无需标定**
> （详见 [`灯带白光自检与排障.md`](灯带白光自检与排障.md)）。只有发现与老口径不符时才回填。

填完把实测灯数写回 `config_ws2812.h` 的 `WS_LED_NUM_*` —— 灯带表与 DMA 缓冲都由它推导，**改这一处就够**。

| 索引 | 通道 / 引脚 | 现填(老从机口径) | 实测亮? | 实测灯数 | 物理归属(靶面/灯臂/侧灯臂/进度条/上下) |
|---|---|---|---|---|---|
| 0 | TIM3_CH1 / PA6 | 87 (上) | ☐ | ____ | ______ |
| 1 | TIM3_CH2 / PA7 | 262 (中) | ☐ | ____ | ______ |
| 2 | TIM3_CH4 / PB1 | 320 (灯臂) | ☐ | ____ | ______ |
| 3 | TIM4_CH1 / PB6 | 120 (侧灯臂)| ☐ | ____ | ______ |
| 4 | TIM4_CH2 / PB7 | 92 (下) | ☐ | ____ | ______ |
| 5 | TIM4_CH3 / PB8 | 0（不驱动——老从机从未驱动该口） | ☐ | ____ | ______ |

判读要点：
- **每条 2s、按索引顺序轮亮**，同一时刻只有一条亮；`g_dbg_ws_scan_idx` 的值 = 当前正在点亮的索引；
- **灯数以末端全亮为准**（目测尾部无残点）：主机当年就是靠这条把 88 定下来的；
- 索引 5 若**完全不亮** → PB8 没接灯带 → 保持 `WS_LED_NUM_SPARE = 0`（当前默认，不分配缓冲/不发送）；只有实测确有点亮且要用它时，才回填实测灯数；
- 扫完把 `DEBUG_TEST_MODE` 改回 0 再出厂；`TEST_TRIGGER_USE_SW2` **必须保持 0**（本板未接拨码，置 1 会因悬空恒高而一上电永久扫描）。

---

## 七、协议速查

**下行（主机 → 从机，ID `0x161`）**

| [0] | [1] 命令 | [2] 大小符 | [3] 灯板号 | [4] 颜色 | [5] 第二块 | [6] 已激活组数 | [7] |
|---|---|---|---|---|---|---|---|
| `AA` | `01`熄灭 `02`点亮 `03`复位 `04`全亮 | `01`大`00`小 | 1~5（全亮/复位时可忽略） | `00`红`01`蓝 | 大符第二块 1~5 | 0~5（进度显示用） | 0 |

**上行（从机 → 主机，ID `0x160`）**

| [0] | [1] | [2] | [3] |
|---|---|---|---|
| `AA` | `03` = 我被打中 | `01` = 我打错了(需复位) | 本机灯板号 |

> ⚠️ 上行是**共用帧结构的重载**：报复位时只改 `[2]`，`[1]` 会残留上一次的 `0x03`
> —— 所以主机侧是**复位优先**判定（`buff_slave_report_parse` 已处理，从机照发即可）。

---

## 八、参考文档（`docs/`）

| 文档 | 用途 |
|---|---|
| `代码架构设计.md` | 分层规则、调度设计、模块职责（**先读**） |
| `能量机关规则.pdf` | 5.5.2.1 状态定义（小符/大符点亮规则、2.5s、1s 窗口、熄灭≤200ms、激活失败条件） |
| `重构对照-旧代码与新设计.md` | 老固件逐行分析（老从机部分见 §2/§3/§6）+ 标定数据继承核对表 |
| `CubeMX校验与踩坑.md` | 生成后必查清单（从机列期望值）与三个坑；**第三节 = DMA 方向坑（从机必看）** |
| [`灯带白光自检与排障.md`](灯带白光自检与排障.md) | **从机看这份**：为何不标定 / 何时才用 / 只能宏触发 / 排障记录表 |
| [`从机S7台架测试指南.md`](从机S7台架测试指南.md) | **S7 开工必读**：五组串行测试的操作步骤、Watch 判据与记录表（判据本体仍看本文 §六） |
| `主机CubeMX配置清单.md` | WS2812/CAN/EXTI 配置参数参考 |
