HonestLeon/2027_Embedded_Buff/docs/原理图/SCH_F405_2026-10-02.pdf

| | | | | | PA8 41 | | PB8 | 61 | ID3 | | | | | | 100nF 5V

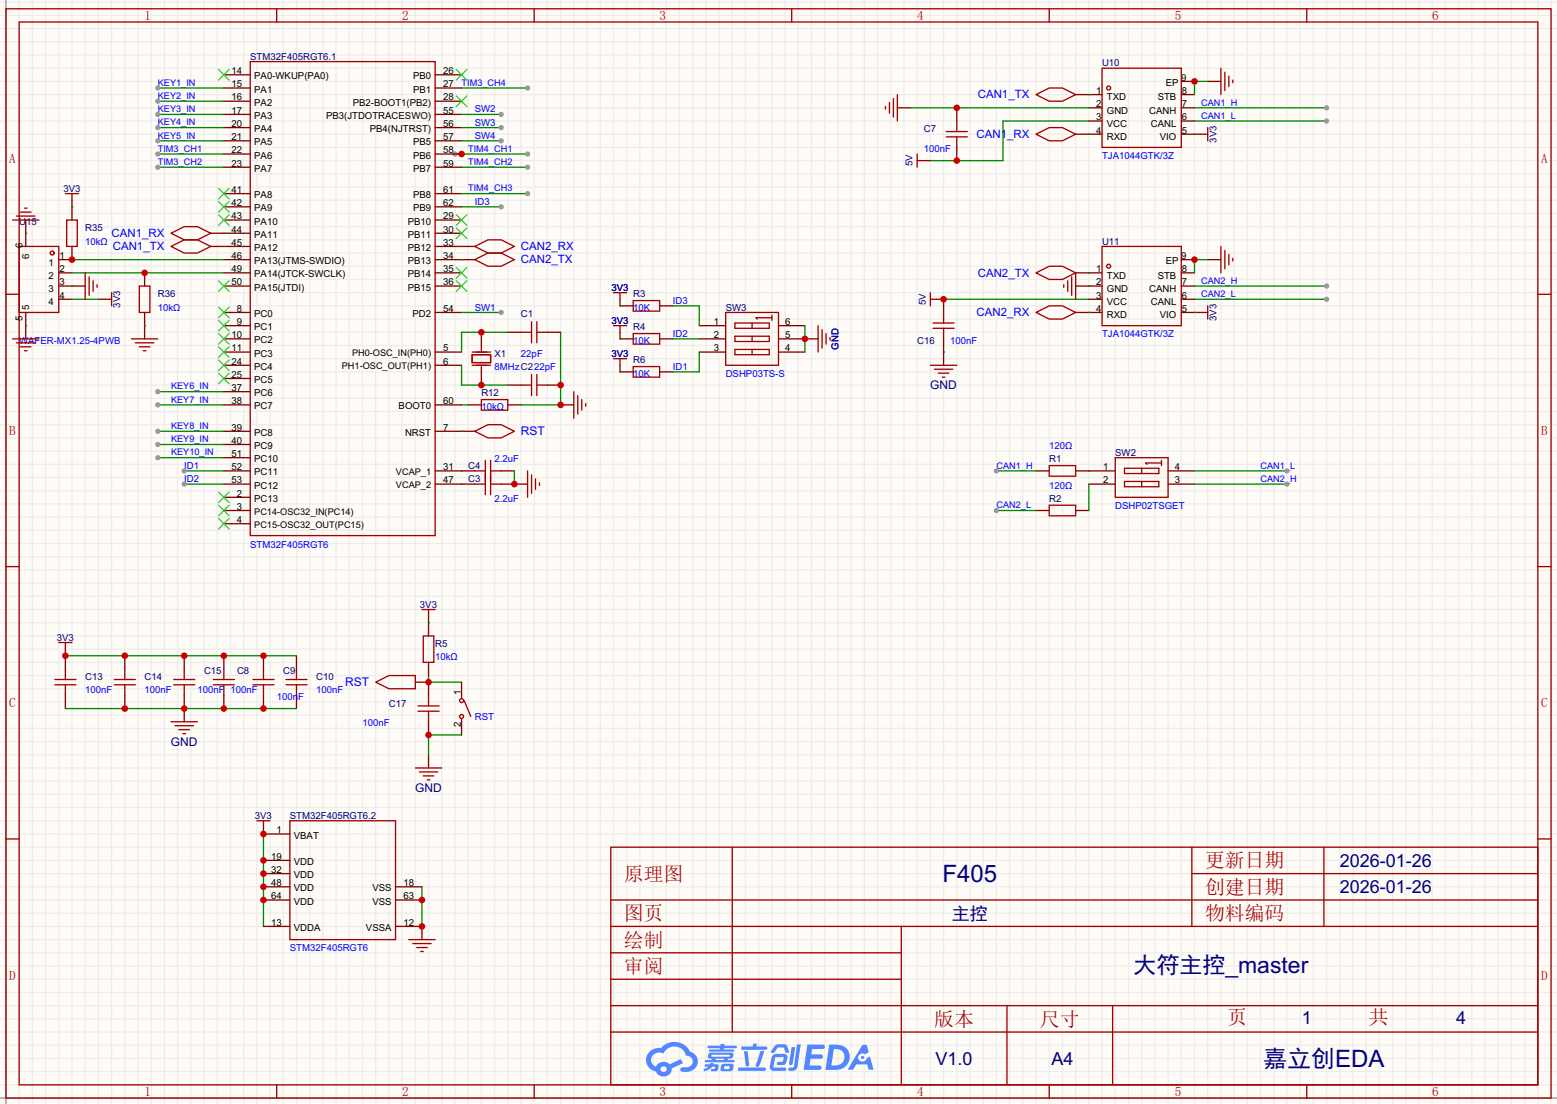
[picture p2: page 1]

STM32F405RGT6.1
PA0-WKUP(PA0) 14 | | | | PB0 | 26 | | | | | | | | EP 9

KEY1_IN KEY2_IN | PA1 15 | | | | PB1 | 27 | TIM3_CH4 | | | CAN1_TX | TXD 1 | | STB | | 8
KEY3_IN | PA2 16 | | PB2-BOOT1(PB2) | | | 28 | | SW2 | | | GND 2 | CANH | | | 7 | CAN1_H
KEY4_IN | PA3 17 | PB3(JTDOTRACESWO) | | | | 55 | | SW3 | | | VCC 3 | CANL | | | 6 | CAN1_L
KEY5_IN | PA4 20 | | | PB4(NJTRST) | | 56 | | SW4 | C7 | CAN1_RX | RXD 4 | | VIO | | 5

A | | TIM3_CH1 TIM3_CH2 | PA6 22 | | | | PB6 | 58 | | TIM4_CH1 TIM4_CH2 | | | TJA1044GTK/3Z | | | | | | A

3V3 | | | | | | | | | TIM4_CH3

R35 | | | | PA10 43 | PB10 | | 29
10kΩ | CAN1_RX | | | PA11 44 | PB11 | | 30 | | | | | | | | | U11
CAN1_TX | | | PA12 45 | PB12 | | 33 | | CAN2_RX

1 | 1 | | | | | PA13(JTMS-SWDIO) 46 | PB13 | | 34 | | CAN2_TX | | | | | | | | | | EP 9
2 | 2 | | | | | PA14(JTCK-SWCLK) 49 | PB14 | | 35 | | | | | | | | CAN2_TX | TXD 1 | | STB | | 8
3 | 3 | | | R36 | | PA15(JTDI) 50 | PB15 | | 36 | | | 3V3 | R3 | | | | | GND 2 | CANH | | | 7 | CAN2_H
4 | 4 | | | | 10kΩ | | | | | SW1 | | | 10K | ID3 | SW3 | | | VCC 3 | CANL | | | 6
WAFER-MX1.25-4PWB³V³ | PC0 8 | | | PD2 | 54 | | | C1 | | 3V3 | | | | | | | | | | CAN2_RX | RXD 4 | VIO | 5

CAN2_L

PC1 9 | | | | | | | | | | R4 | | | 1 | | 6 | | | | | TJA1044GTK/3Z
PC2 10 | | | | | | | | | 10K | | | ID2 | 2 | | 5 | | C16 | 100nF
PC3 11 | PH0-OSC_IN(PH0) | | | 5 | X1 | | 22pF | | 3V3 | R6 | | | 3 | | 4
PC4 24 | PH1-OSC_OUT(PH1) | | 6 | 8MHzC222pF | 10K | ID1

KEY6_IN | PC5 25 | | | | | | | GND
KEY7_IN | PC6 37 | | | | R12

PC7 38 | | BOOT0 | 60 | 10kΩ

B | KEY9_IN | | PC8 39 | | NRST | 7 | | | RST | | | | | | | B

KEY8_IN
KEY10_IN | | PC9 40 | | | | | | | | 120Ω | | SW2
ID1 | PC10 51 | | | | C4 | 2.2uF | | CAN1_H | R1 | | | | CAN1_L

PC11 52 | VCAP_1 | | 31 | | | | | | 1 | | 4

ID2 | PC12 53 | VCAP_2 | | 47 | C3 | | | | 120Ω | 2 | | 3 | CAN2_H

PC13 2 | 2.2uF | CAN2_L | R2
PC14-OSC32_IN(PC14) 3
PC15-OSC32_OUT(PC15) 4

DSHP02TSGET

R5
10kΩ

C13 100nF | C14 100nF | | | 100nF | | | C10 100nF | RST

RST

3V3 | STM32F405RGT6.2
VBAT 1
VDD 32 | | | | 原理图 | | | 更新日期 | | 2026-01-26 F405
VDD 19 | 2026-01-26
VDD 48 | VSS | 18 | | | | | 创建日期
VSS | 63 VDD 64

图页 | 主控 | | 物料编码
绘制

VSSA | | 12 VDDA 13

STM32F405RGT6

D | | | | | 审阅 | 大符主控_master | D

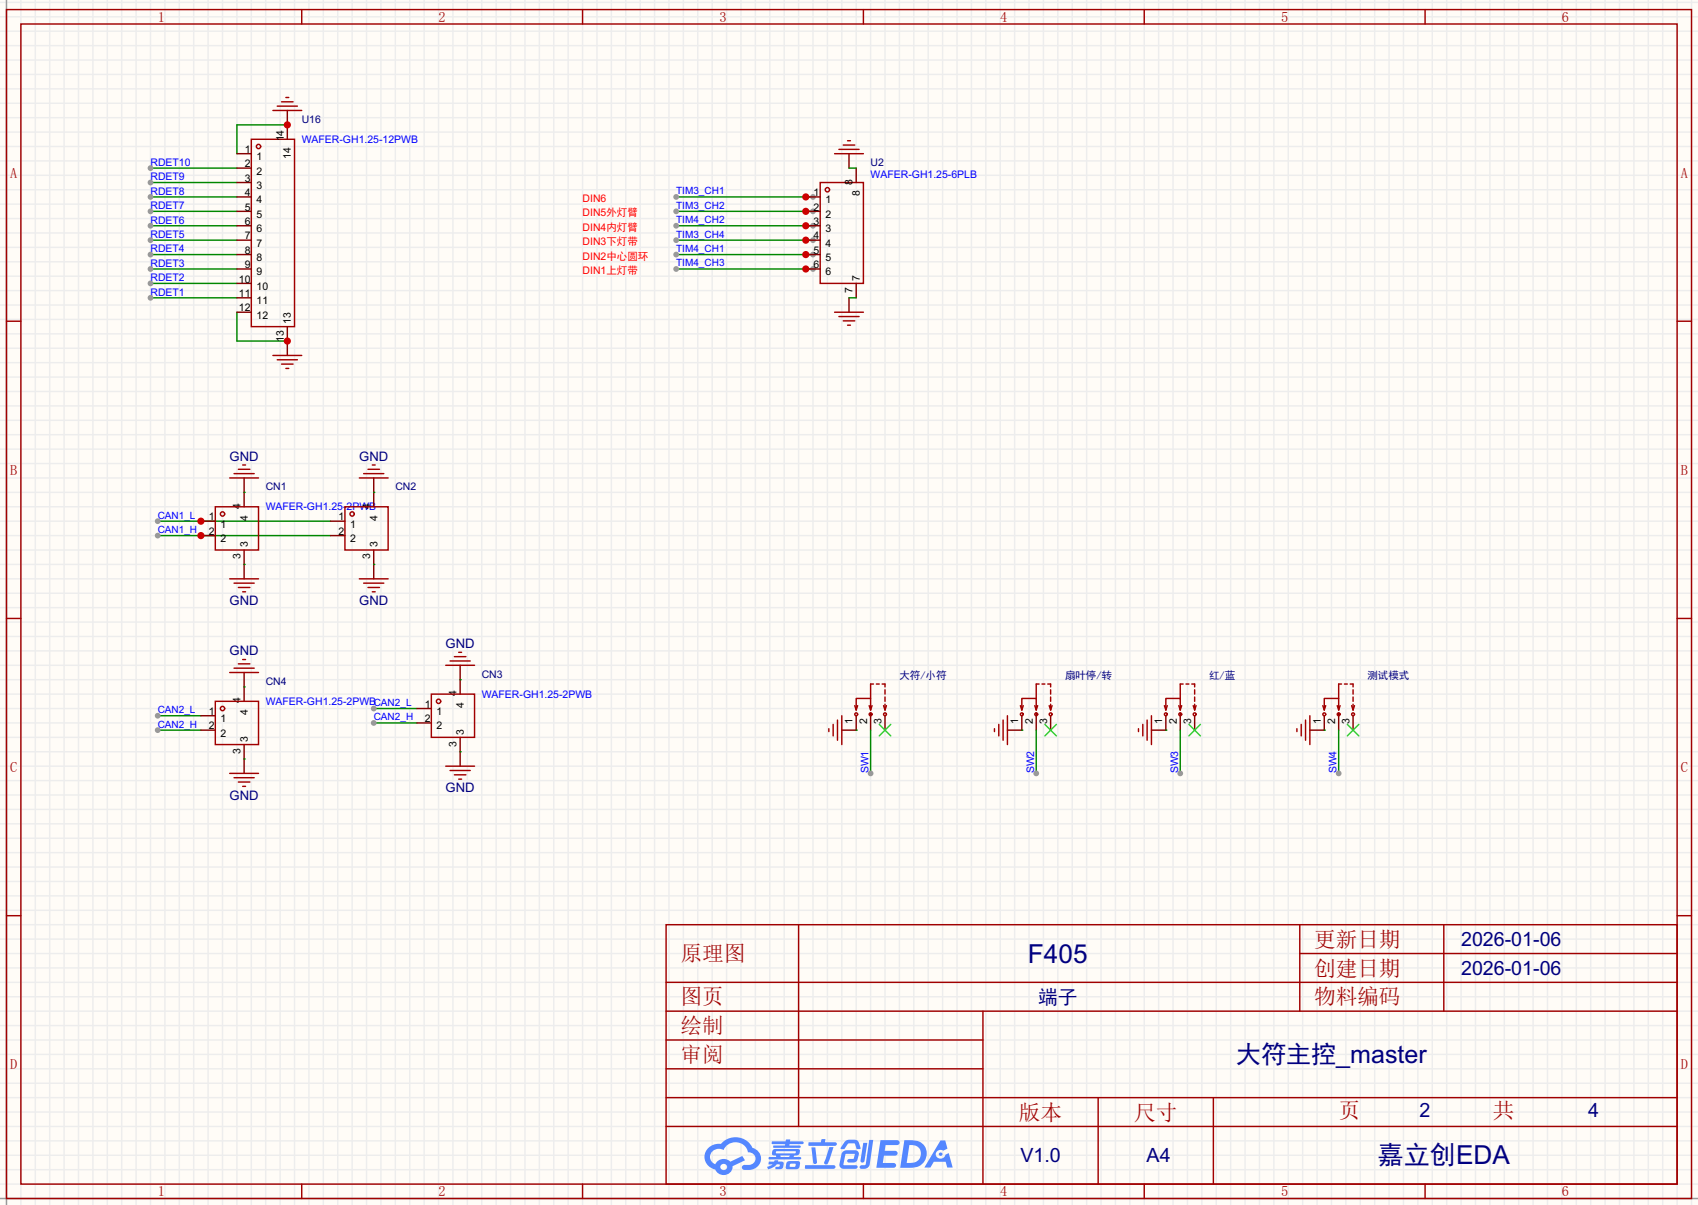
[picture p3: page 2]

U16
WAFER-GH1.25-12PWB

A | RDET10 | 2 | 2 | | | | | | U2 WAFER-GH1.25-6PLB | A

RDET9
3 | 3 | | | TIM3_CH1
RDET8
RDET7
RDET6
RDET5 | 7 | 7 | DIN3下灯带 | TIM3_CH4 TIM4_CH1 | 4 | 4
RDET4
RDET3
RDET2
RDET1

4 | 4 | | DIN6 | TIM3_CH2 | 1 | 1
5 | 5 | DIN5外灯臂 | TIM4_CH2 | 2 | 2
6 | 6 | DIN4内灯臂 | | 3 | 3

8 | 8 | DIN2中心圆环 | TIM4_CH3 | 5 | 5
9 | 9 | DIN1上灯带 | | 6 | 6
10 10
11 11
12 12

GND | | GND

CAN1_L | 1 | | 1
CAN1_H | 2 | 1 | 2 | 1

CN4 | CN3 | | 大符/小符 | 扇叶停/转 | 红/蓝 | 测试模式

WAFER-GH1.25-2PWB | CAN2_L | 1 | | 4
CAN2_H | 1 | 1 | | CAN2_H | 2 | 1

WAFER-GH1.25-2PWB

GND

原理图 | | | 更新日期 | 2026-01-06 F405

创建日期

图页 | 端子 | | 物料编码
绘制

D | 审阅 | | 大符主控_master | | | D

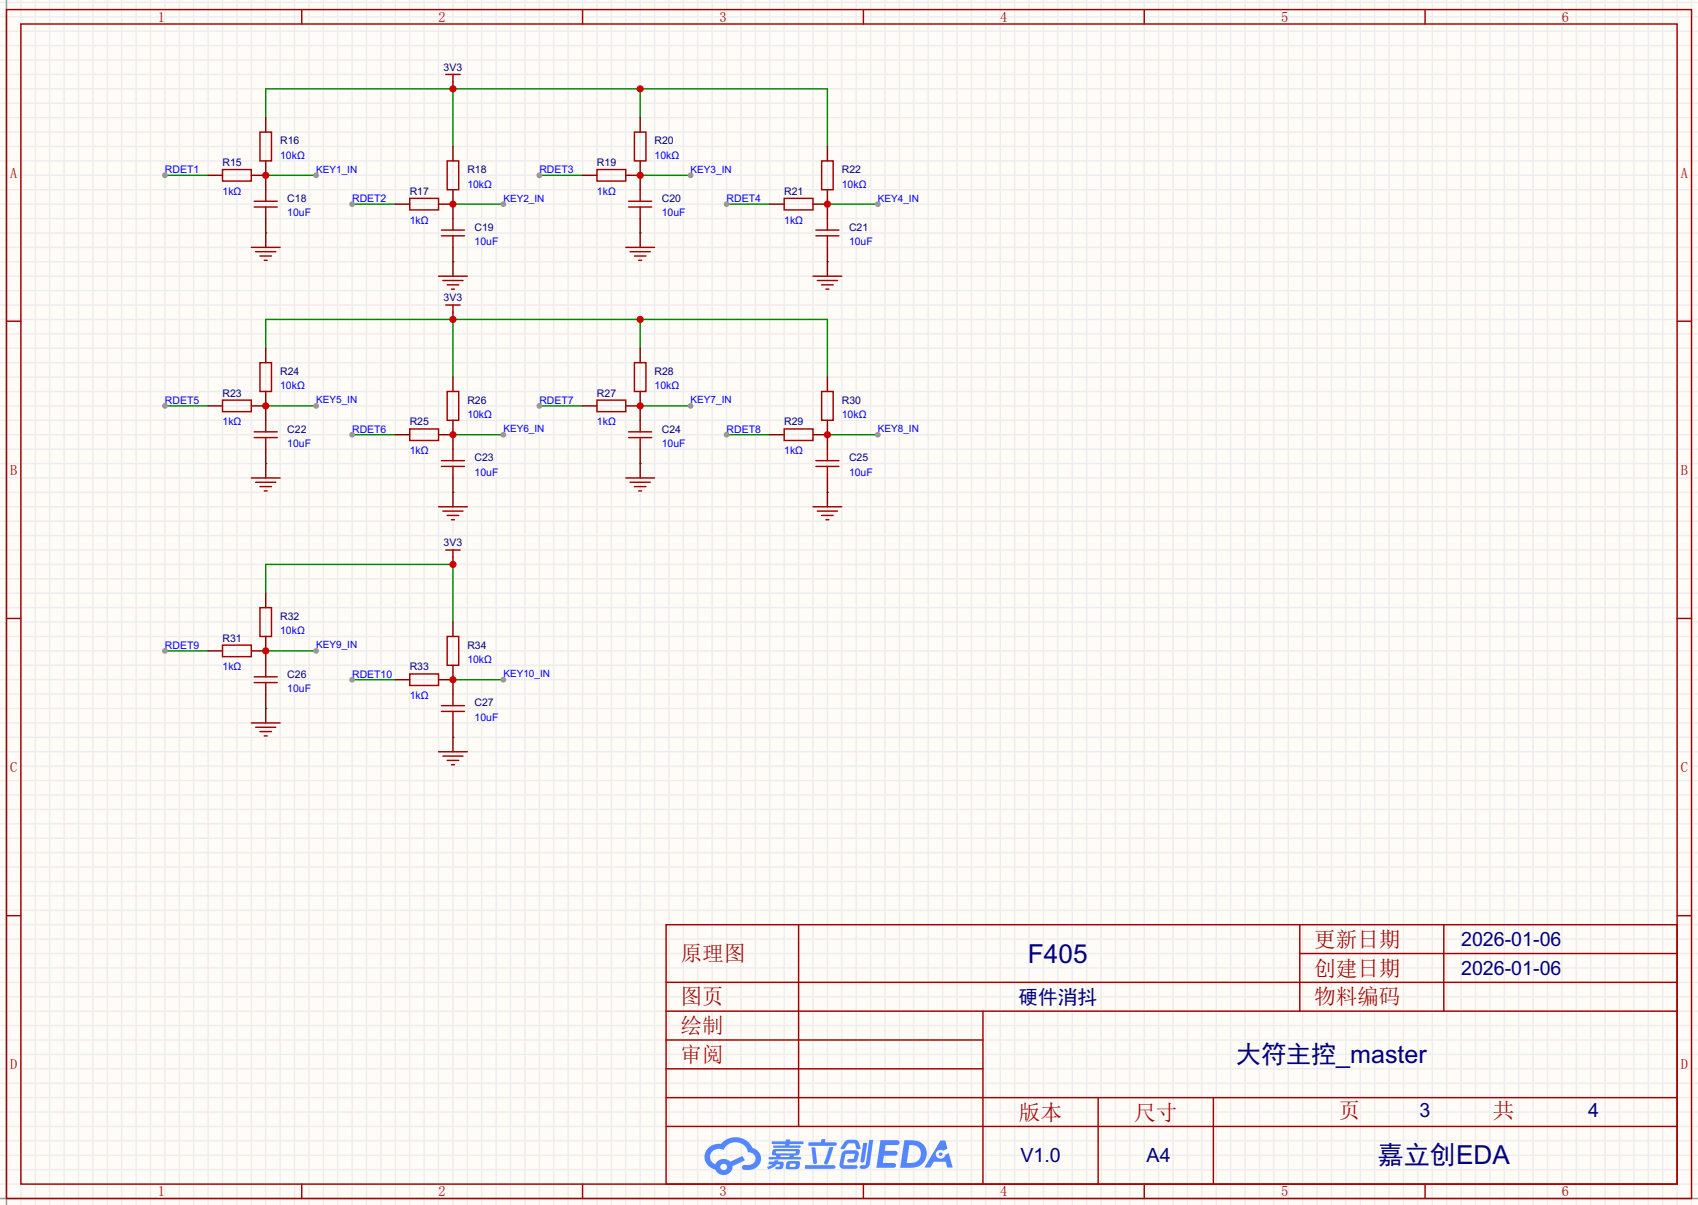
[picture p4: page 3]

R16 | | | | | | | | R20
10kΩ | | | | | | | | 10kΩ

A | RDET1 | R15 | | KEY1_IN | | | R18 | | RDET3 | R19 | | KEY3_IN | | | R22 | | A

C18 | | RDET2 | | | KEY2_IN | | | C20 | | RDET4 | | | KEY4_IN
10uF | | | 1kΩ | | | | | 10uF | | | 1kΩ

C19 | | | | | | | | C21
10uF | | | | | | | | 10uF

RDET5 | | | KEY5_IN | | | R26 | | RDET7 | | | KEY7_IN | | | R30

C22 | | RDET6 | | | KEY6_IN | | | C24 | | RDET8 | | | KEY8_IN

RDET9 | | | KEY9_IN | | | R34

1kΩ | C26 | | RDET10 | R33 | | KEY10_IN

C27
10uF

原理图 | | | 更新日期 | 2026-01-06 F405

创建日期

图页 | 硬件消抖 | | 物料编码
绘制

D | 审阅 | | 大符主控_master | | | D

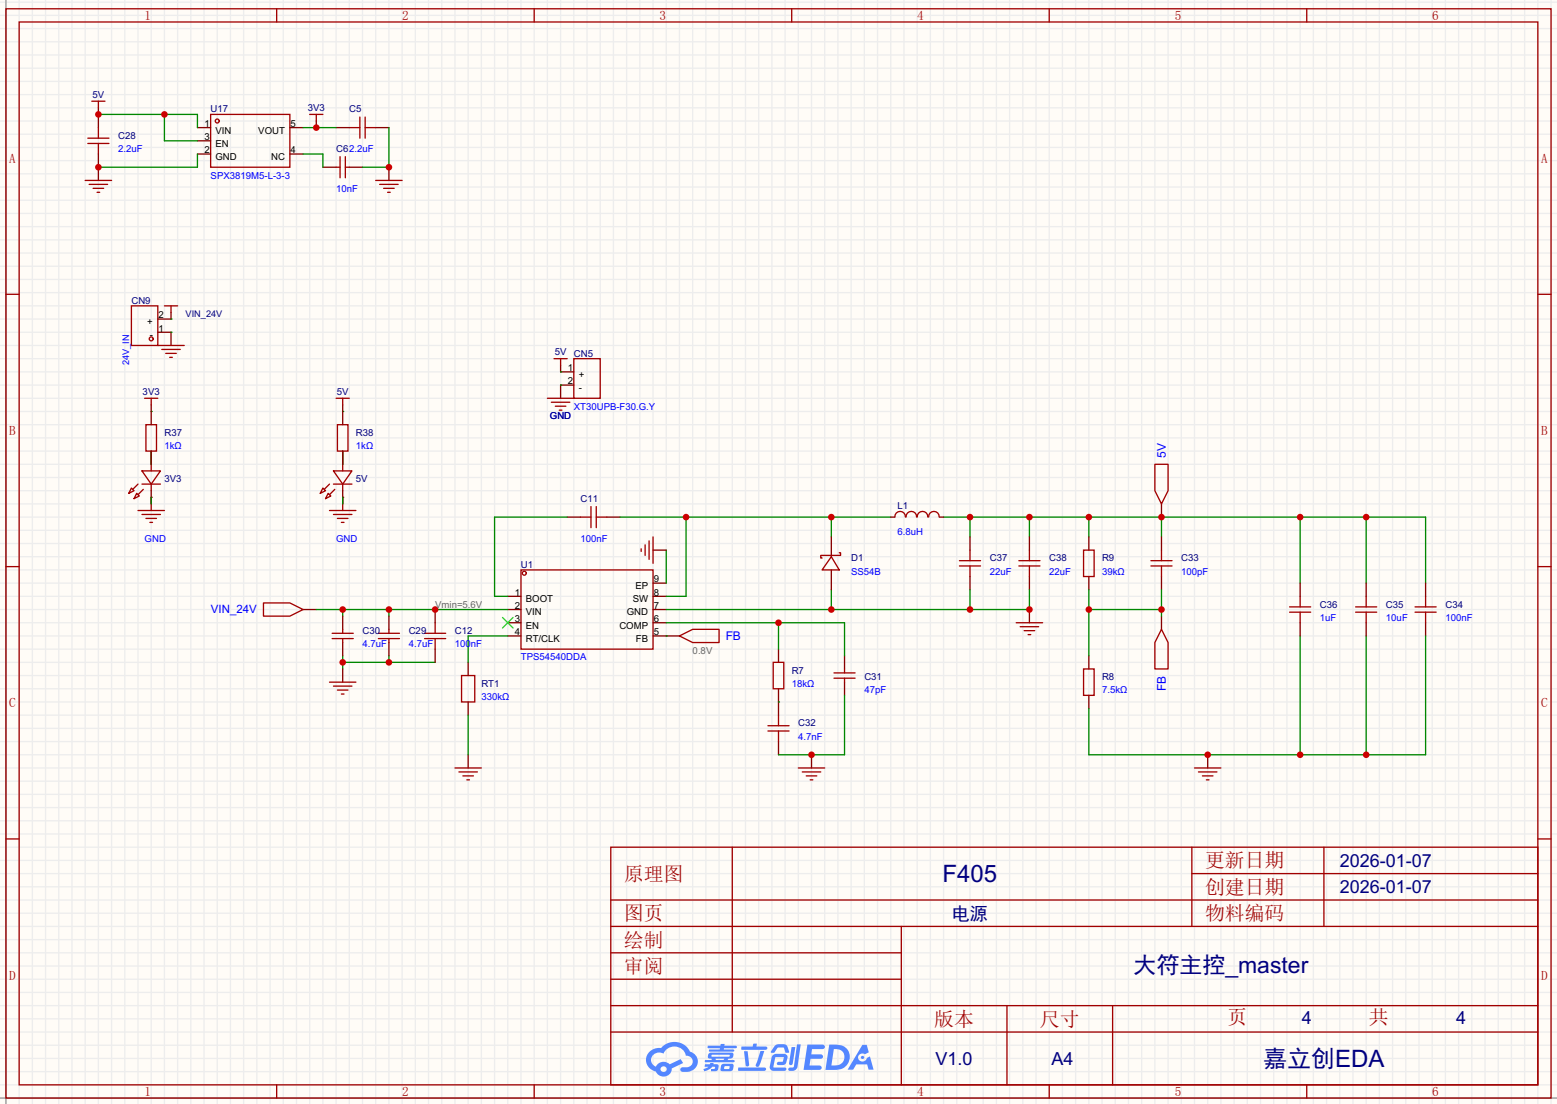
[picture p5: page 4]

C28 | VIN 1 | | VOUT 5

A | 2.2uF | | GND 2 | | NC 4 | C6 | 2.2uF | A

SPX3819M5-L-3-3

CN9
2 | | VIN_24V
+ 1

5V | | CN5

XT30UPB-F30.G.Y
GND

GND | GND | 100nF

BOOT 1 | SW | 8

VIN_24V | | | Vmin=5.6V | | | | | VIN 2 | | | GND | | 7 | | | | | | | | | | | C36 | | C35 | | C34

EN 3 | | | COMP | | 6 | | | | | | | | | | | | 1uF | | 10uF | | 100nF

C30 | C29 | | C12 | | | RT/CLK 4 | | | FB | | 5 | | | FB
4.7uF | 4.7uF | | 100nF | | | | | | | | | | 0.8V

TPS54540DDA

C32
4.7nF

原理图 | | | 更新日期 | 2026-01-07 F405

创建日期

图页 | 电源 | | 物料编码
绘制

D | 审阅 | | 大符主控_master | | | D
