HonestLeon/2027_Embedded_Buff/2027_Embedded_Buff_Slave/Core/Src/main.c

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
/* Includes ------------------------------------------------------------------*/
#include "main.h"
#include "can.h"
#include "dma.h"
#include "rng.h"
#include "tim.h"
#include "gpio.h"

/* USER CODE BEGIN Includes */
#include <stdlib.h>
#include "bsp_ws2812.h"
#include "bsp_switch.h"
#include "bsp_can.h"
#include "bsp_rng.h"
#include "buff.h"
#include "light.h"
#include "hit_detect.h"
/* USER CODE END Includes */


void SystemClock_Config(void);
/**
  * @brief  The application entry point.
  * @retval int
  */
int main(void)
{

  /* MCU Configuration--------------------------------------------------------*/

  /* Reset of all peripherals, Initializes the Flash interface and the Systick. */
  HAL_Init();

  /* Configure the system clock */
  SystemClock_Config();

  /* Initialize all configured peripherals */
  MX_GPIO_Init();
  MX_DMA_Init();
  MX_CAN1_Init();
  MX_RNG_Init();
  MX_TIM3_Init();
  MX_TIM4_Init();
  MX_TIM6_Init();
  MX_CAN2_Init();
  /* USER CODE BEGIN 2 */
  /* 初始化序列(顺序见《代码架构设计》四.3):
     ①等 WS2812 供电稳 → ②各模块 init → ③最后启动 1ms 调度中断 */
  HAL_Delay(100);                   /* 等 WS2812 供电稳 */
  bsp_ws2812_init();
  bsp_switch_init();
  bsp_can_init();
  srand(bsp_rng_get_seed());
  buff_init();
  light_init();
  hit_detect_init();          /* S4: EXTI 击打记录(EXTI 已在 MX_GPIO_Init 使能, 回调只记录) */
  HAL_TIM_Base_Start_IT(&htim6);    //中断调度开始
  /* USER CODE END 2 */

  /* Infinite loop */
  /* USER CODE BEGIN WHILE */
  while (1)
  {
    //__WFI();    /* 空转等中断: 调度全在 TIM6(主循环保持为空是架构纪律) */
    /* USER CODE END WHILE */

    /* USER CODE BEGIN 3 */
  }
  /* USER CODE END 3 */
}

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
