HonestLeon/2027_Embedded_Buff/2027_Embedded_Buff_Slave/2027_Embedded_Buff_Master.ioc

Mcu.UserName=STM32F405RGTx
PA1.GPIO_Label=KEY1
PA1.Signal=GPXTI1
PA11.Signal=CAN1_RX
PA12.Signal=CAN1_TX
PA13.Signal=SYS_JTMS-SWDIO
PA14.Signal=SYS_JTCK-SWCLK
PA2.GPIO_Label=KEY2
PA2.Signal=GPXTI2
PA3.GPIO_Label=KEY3
PA3.Signal=GPXTI3
PA4.GPIO_Label=KEY4
PA4.Signal=GPXTI4
PA5.GPIO_Label=KEY5
PA5.Signal=GPXTI5
PA6.Signal=S_TIM3_CH1
PA7.Signal=S_TIM3_CH2
PB1.Signal=S_TIM3_CH4
PB12.Signal=CAN2_RX
PB13.Signal=CAN2_TX
PB3.GPIO_Label=SW_RUN
PB3.Signal=GPIO_Input
PB4.GPIO_Label=SW_COLOR
PB4.Signal=GPIO_Input
PB5.GPIO_Label=SW_DEBUG
PB5.Signal=GPIO_Input
PB6.Signal=S_TIM4_CH1
PB7.Signal=S_TIM4_CH2
PB8.Signal=S_TIM4_CH3
PB9.GPIO_Label=BOARD_ID3
PB9.Signal=GPIO_Input
PC10.GPIO_Label=KEY10
PC10.Signal=GPXTI10
PC11.GPIO_Label=BOARD_ID1
PC11.Signal=GPIO_Input
PC12.GPIO_Label=BOARD_ID2
PC12.Signal=GPIO_Input
PC6.GPIO_Label=KEY6
PC6.Signal=GPXTI6
PC7.GPIO_Label=KEY7
PC7.Signal=GPXTI7
PC8.GPIO_Label=KEY8
PC8.Signal=GPXTI8
PC9.GPIO_Label=KEY9
PC9.Signal=GPXTI9
PD2.GPIO_Label=SW_BUFF
PD2.Signal=GPIO_Input
PH0-OSC_IN.Signal=RCC_OSC_IN
PH1-OSC_OUT.Signal=RCC_OSC_OUT
