HonestLeon/2027_Embedded_Buff/2027_Embedded_Buff_Master/Core/Inc/main.h

#define KEY1_Pin GPIO_PIN_1
#define KEY1_GPIO_Port GPIOA
#define KEY1_EXTI_IRQn EXTI1_IRQn
#define KEY2_Pin GPIO_PIN_2
#define KEY2_GPIO_Port GPIOA
#define KEY2_EXTI_IRQn EXTI2_IRQn
#define KEY3_Pin GPIO_PIN_3
#define KEY3_GPIO_Port GPIOA
#define KEY3_EXTI_IRQn EXTI3_IRQn
#define KEY4_Pin GPIO_PIN_4
#define KEY4_GPIO_Port GPIOA
#define KEY4_EXTI_IRQn EXTI4_IRQn
#define KEY5_Pin GPIO_PIN_5
#define KEY5_GPIO_Port GPIOA
#define KEY5_EXTI_IRQn EXTI9_5_IRQn
#define KEY6_Pin GPIO_PIN_6
#define KEY6_GPIO_Port GPIOC
#define KEY6_EXTI_IRQn EXTI9_5_IRQn
#define KEY7_Pin GPIO_PIN_7
#define KEY7_GPIO_Port GPIOC
#define KEY7_EXTI_IRQn EXTI9_5_IRQn
#define KEY8_Pin GPIO_PIN_8
#define KEY8_GPIO_Port GPIOC
#define KEY8_EXTI_IRQn EXTI9_5_IRQn
#define KEY9_Pin GPIO_PIN_9
#define KEY9_GPIO_Port GPIOC
#define KEY9_EXTI_IRQn EXTI9_5_IRQn
#define KEY10_Pin GPIO_PIN_10
#define KEY10_GPIO_Port GPIOC
#define KEY10_EXTI_IRQn EXTI15_10_IRQn
#define BOARD_ID1_Pin GPIO_PIN_11
#define BOARD_ID1_GPIO_Port GPIOC
#define BOARD_ID2_Pin GPIO_PIN_12
#define BOARD_ID2_GPIO_Port GPIOC
#define SW_BUFF_Pin GPIO_PIN_2
#define SW_BUFF_GPIO_Port GPIOD
#define SW_RUN_Pin GPIO_PIN_3
#define SW_RUN_GPIO_Port GPIOB
#define SW_COLOR_Pin GPIO_PIN_4
#define SW_COLOR_GPIO_Port GPIOB
#define SW_DEBUG_Pin GPIO_PIN_5
#define SW_DEBUG_GPIO_Port GPIOB
#define BOARD_ID3_Pin GPIO_PIN_9
#define BOARD_ID3_GPIO_Port GPIOB
