HonestLeon/2027_Embedded_Buff/2027_Embedded_Buff_Slave/config/config_light.h

/**
 * @file config_light.h
 * @brief 灯板图案标定(2025 原值, ⚠️ 勿改) + 从机侧灯效参数 —— 2027 **从机**固件
 *
 * ── 以下为 2025 赛季灯板图案标定, 逐颗数出, ⚠️ 原值勿改(见《重构对照》核对表)──
 *   从机就是这些图案的主人: 老 Buff_Activating / Activatable / Arrowhead 都是从机代码。
 *   段号是"第几颗灯珠", 画在哪条灯带由下面 SLV_STRIP_* 决定 —— 映射与段号均继承老从机（硬件与 2025 相同，无需标定）；仅异常时按《从机灯带自检与排障》复核。
 *   主机同名文件里这些表是"备查副本"(主机不引用), 改动同样**只许搬位置、不许改值**。
 */
#ifndef CONFIG_LIGHT_H
#define CONFIG_LIGHT_H

/* 环数→LED段(灯板靶面, 1~10环 {起始,长度}) —— 老Buff_Activating原值 */
#define LIGHT_RING_MAP { \
    {258,4},{250,8},{237,13},{221,16},{196,25},   /* 1~5环 */ \
    {166,30},{133,33},{94,39},{49,45},{0,49},      /* 6~10环 */ \
}

/* 待激活图案段表 —— 老Buff_Activatable原值(从机灯板用, 共19段) */
#define LIGHT_ARMED_SEGS { {0,1},{12,2},{24,2},{36,2},{48,46},{94,1},{103,2}, \
    {113,2},{122,3},{132,2},{141,2},{149,2},{157,2},{165,2},{173,2},{181,1}, \
    {188,2},{196,25},{250,8} }

/* 箭头模板行 {起始,宽度} —— 老Buff_Arrowhead原值 */
#define LIGHT_ARROWHEAD_ROWS { {3,2},{10,4},{17,2},{21,2},{24,2},{30,2} }

/* 白光测试: 每条持续时间(4Hz tick数), 8×250ms=2s —— 灯带自检/排障要用（从机只能宏触发） */
#define LIGHT_TEST_TICKS        8u

/* 箭头流动相位步进节拍: 每 4 个 4Hz 逻辑帧走一步(≈1s/步) —— 对齐老观感
 * (老从机主循环≈200ms 一圈、`i` 数到 4 才让 test_num 置位 → ≈800ms/步;
 *  若每帧一步会比老代码快 4 倍, 见《从机重构清单》§3.5 动画节拍) */
#define LIGHT_ARROW_STEP_TICKS  4u

/* ── 从机侧灯效参数(S1 新增) ────────────────────────────────
 * 索引 = config_ws2812.h 的 WS2812_STRIP_TBL 行号；对应关系取自 2025 老从机代码，
 *  索引↔功能已按老从机 DMA 绑定核对；只剩“哪条在机械上叫什么”待结构组确认(H5)。 */
#define SLV_STRIP_TARGET      1u   /* 靶面(老 LED_ROAD_2 "中", 262) —— 环数 + 待激活图案 */
#define SLV_STRIP_ARM         2u   /* 灯臂(老 LED_ROAD_4, 320) —— 箭头流动 + 进度条 */
#define SLV_STRIP_ARM_SIDE    3u   /* 侧灯臂(老 LED_ROAD_5, 120) —— 进度条 */
#define SLV_STRIP_UP          0u   /* 上(老 LED_ROAD_3, 87) */
#define SLV_STRIP_DOWN        4u   /* 下(老 LED_ROAD_1, 92) */

/* 亮度(老从机代码) —— 0/255 位序对称不受影响; 中间值踩"位序陷阱": 2025 老驱动位展开
 * 是 LSB-first(与 WS2812 要求相反), 老固件里的 10(0x0A) 打到灯珠实际是 80(0x50)。
 * 老代码**调用点**分两档(验收修正版, 逐行核对 main.c/WS2812.c):
 *   255 = 靶面 19 段(Activatable 传 255) + 环数段(Activating 内部写死);
 *   10  = 箭头(Flowing 传 10) + state3 灯臂两条常亮 + state4 全激活 —— 三处实际观感≈80。
 * (">0→255"阈值化只存在于老死代码 Buff_Unactivated 系列与 Buff_Heart, 从机从未调用, 别当依据)
 * 新驱动 MSB-first: 三处"10"照抄会暗 8 倍 → 10/80 观感 S7 组 4 台架定, 本文件一处改。 */
#define SLV_LEVEL_FULL        255u /* 靶面 19 段 / 环数段(老调用即 255, 位序无关) */
#define SLV_LEVEL_ARROW        10u /* 待激活箭头定值(老调用传 10; 位序陷阱受害处①, S7 组 4 定值) */
#define SLV_LEVEL_PROGRESS     10u /* ACTIVATED 灯臂+侧灯臂整条常亮(老"设计值"10; 位序陷阱受害处②,
                                    * 老实际观感≈80; S8 进度条亮度同源; 10/80 归 S7 组 4) */
#define SLV_LEVEL_ALL_ON       10u /* 全激活亮度(位序陷阱受害处③; ⚠ 外观还要与规则图 5-23 核对) */
#define SLV_LEVEL_SLEEP         0u /* 休眠 = 全灭(位序无关) */

/* 老"全激活"(state 4)只点亮 上/下 两条 —— S6.5 与规则图核对后再定要点几条 */
#define SLV_ALL_ON_STRIP_MASK  ((1u<<SLV_STRIP_UP)|(1u<<SLV_STRIP_DOWN))

/* 进度条分 5 段(规则 5.5.2.1: 灯臂中部指示激活进度 n/5)，每段灯数运行时按灯带总长算 */
#define SLV_PROGRESS_STEPS     5u

#endif /* CONFIG_LIGHT_H */
