HonestLeon/2027_Embedded_Buff/(commit log)

2026-10-03 init: CubeMX 生成的主机基础工程
    - STM32F405RGT6, 168MHz, CubeMX 6.15 生成
    - 外设: TIM3/TIM4 六路 WS2812 PWM+DMA, TIM6 1ms 节拍,
    CAN1/CAN2, RNG, EXTI(KEY1~10), 拨码开关 GPIO, DSP 库
    - 配置依据见《主机CubeMX配置清单》
2026-10-05 feat(架构): 按 config/bsp/application 分层落地代码骨架 (P0~P3)
    新增三个目录(与 Core 平级):
    - config/ : 6 个配置头(纯宏与 const 表) —— board/can/ws2812/motor/buff/light
    - bsp/ : 4 个板级模块 —— bsp_ws2812 / bsp_can / bsp_switch / bsp_rng
    - application/ : 3 个业务模块 —— motor / buff / light (hit_detect 属从机,主机构建不含)
    P2 驱动:
    - bsp_ws2812: PWM 周期=1bit(800kHz) + DMA 灌 CCR; RGB 逻辑缓冲 + dirty/busy 握手;
    HAL_TIM_PWM_PulseFinishedCallback 按 htim->Channel 精确释放(同定时器多通道可区分);
    复位段 50→90bit(112µs); 修复老代码"每圈无条件重启 DMA"与"只上电刷一次"两个 bug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
2026-10-05 chore: 新增从机工程起手模板 + 更新仓库说明
    - 新增 2027_Embedded_Buff_Slave/: 主机工程(P3 完成时)的快照, 作为从机(打符灯板)
    工程的基础。不含 Drivers/(CubeMX 生成时自动补齐), 仅 336KB
    - 新增 README_从机改动清单.md: 从机开工的完整 checklist
    * CubeMX 加回: 10 个 KEY 引脚 + 6 个 EXTI 中断; TIM4 三通道 + TIM3 CH2/CH4;
    5 条 DMA 流(全部 Direction=Memory To Peripheral!) + 对应 5 个 DMA 中断
    * 代码改动: BOARD_ROLE_MASTER=0、灯带表与缓冲按从机接线重填(参考老口径
    92/262/87/320/120)、新增 hit_detect.c、buff.c 换从机状态机并主动上报、
    light.c 图案换成待激活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
2026-10-05 docs: 设计文档纳入仓库(docs/) 并更新索引
    - 新增 docs/: 8 份设计文档 + 原理图(PDF/SVG)
    * 代码架构设计 / 重构对照-旧代码与新设计 / 主机CubeMX配置清单 / CubeMX裁剪说明
    * 白光测试指南 / P3调试指南 / 代码重构计划 / 大符思路.txt
    * 原理图/(主从共用板 V1.0, 文档多处引用)
    - README.md: 文档索引改为仓库内相对链接, 并注明"母版在上级目录, 改动需两处同步"
    - 从机模板 README: 参考资料路径同步为仓库 docs/
    至此仓库自包含: 克隆即可拿到代码 + 全部设计依据。
2026-10-05 删去主机冗余外设
2026-10-05 feat(can): bsp_can 双总线实现 + buff 协议 pack/parse (P4)
    bsp_can (bsp/bsp_can.c 完整实现):
    - 过滤器: 32 位 MASK 模式, CAN1 用 bank0(收 0x160~0x167),
    CAN2 用 bank14(收 0x200~0x207, >= SlaveStartFilterBank 才生效)
    - 接收: 中断内仅 GetRxMessage + 按 hcan->Instance 分发到各自环形队列
    (CAN1 深 16 / CAN2 深 32, 长度入 config_can.h; 2 的幂以便位与取模)
    双队列分离的原因: 电机反馈 ~1kHzx4 与从机帧 4Hz 混用会互相拖延
    - 发送: 零等待 —— 查一次空邮箱, 满即丢弃并计数
    (不能用 HAL_GetTick 做超时: TIM6 优先级 2 高于 SysTick 15, 超时永不触发)
    - 计数可观测: 各总线 tx_drop / rx_dro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
2026-10-05 feat(motor): P5 电机控制落地 + SW2 归还"停/转"
    application/motor.c (老 motor_control/PID_Calc/Zero_Check 逐行迁移):
    - 速度给定: 小符匀速 π/3 rad/s; 大符 v = A·sin(w·t) + B (A=1,W=1.9,B=1.09)
    - 目标位置积分: target += CIRCLE_NUM/(2π/v) * dt (CIRCLE_NUM=153.5 老值)
    - 位置反馈: 编码器角度→度→Zero_Check 过零圈数 + 角度/360
    - 双环纯 P: 位置环 P=200 (输出取负作速度环给定) → 速度环 P=15 → 电流
    - 大符叠加前馈 FF_K·cos(w·t+φ) (5000 / -0.45π); 停转时电流强制 0(老行为)
    - 0x200 每 1ms 发(含停转保活帧), 发送周期由 MOTOR_TX_PERIOD_MS 可调
    - 反馈走 bsp_can2_pop 每 1ms 排空(老代码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
2026-10-05 fix(can): CAN2 波特率纠正为 1Mbps(依据旧工程生成代码), 并更新文档
    发现: 旧主/旧从机的 Core/Src/can.c 里 CAN1 与 CAN2 **都是**
    Prescaler=3 / BS1=10TQ / BS2=3TQ → 42MHz/3/14 = 1Mbps。
    旧 .ioc 里 "CAN2=100kbps" 属陈旧值(同一 ioc 连 CAN1 条目都缺失, 而代码在用 hcan1), 不可采信。
    影响: 新工程 CAN2 曾按 100kbps(P=28/BS1=11/BS2=3) 配置 → 电机不会响应。
    改动: 文档记录结论与修正步骤(CubeMX 改 P=3/BS1=10/BS2=3);
    config_motor.h 的 MOTOR_TX_PERIOD_MS 注释按 1Mbps 容量核算更新
    (1kHz 发帧≈13% + 反馈≈13% → 总≈26%, 1ms 周期可行)。
    ⚠ 待用户执行: CubeMX 里把 CAN2 位率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
2026-10-05 feat(motor): 增加电机环调试快照 g_dbg_motor, 便于台架核对
    新增(g_dbg_motor, 长期保留): fb_angle/fb_speed(电调反馈)、target/position/delat(位置环)、
    cmd_current(电流指令)、fb_frames(反馈帧累计计数)。
    用途: 一眼判断"速度环是否真的闭环"(fb_frames 是否增长) —— 若反馈未收到, 速度环退化为
    开环饱和, 实际转速会与设计不同。
    同时: 对比新旧转速的计算公式已确认逐行等价(小符 π/3 → 目标 25.58 圈/秒 → 机构 6.0 s/圈;
    大符 A·sin(wt)+B; 前馈/双环/限幅/过零/停转清零全部一致); 旧代码 ChassisMotorCanReceive[i]
    的全局 i 从未被修改, 恒等于 [0], 故不构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
2026-10-05 docs: 灯带灯数复核结案(88颗全亮) + 新增电机圈时间标定待办
2026-10-05 feat(buff): P6 大小符状态机 + 随机序列(老算法迁移, 修正越界 bug)
    application/buff.c 新增:
    - buff_random_small / buff_random_big: 老 generateUniqueRandomArray_* 算法原样,
    去掉函数内部的 srand(CNT_my)/srand(random_seed)(CNT_my 在新架构无人递增, TIM2 已删),
    种子由上电 srand(bsp_rng_get_seed()) 注入
    - buff_slave_report_parse: 从机回报解析(0x03 被击中 / 0x01 打错复位), 复位优先判定
    - bb_state_t 六状态机: RESET→IDLE→LIT→(大符)HIT_WINDOW→COOLDOWN→ALL_ON→RESET
    计时由 buff_tick(1ms) 驱动: 2.5s 超时 / 1s 首击窗口 / 5ms 熄灭间隔
    老的 6 个标志(finish_flag/first_hit_flag/wait_t/counter_start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
2026-10-05 feat(buff): 增加 BUFF_SMALL_HIT_COUNT 开关(默认5=按规则, 可设6=复刻老固件)
    背景: 2025 老固件小符分支 `num[counter]` 在 counter==5 时越界读(读到相邻数组 num2[0]),
    导致实际需要点亮/击中 6 次才全亮(第 6 次重复点亮一个已打过的灯板)。
    本提交: 命中次数做成配置项 BUFF_SMALL_HIT_COUNT
    - 5 (默认): 按 RM 规则, 5 个灯板各一次
    - 6 : 复刻老行为, 第 6 次显式重新点亮 s_small[0](把越界读变成有定义的行为)
    行为推演已验证:
    5 → 点亮 s[0]→s[1]→s[2]→s[3]→s[4] → 全亮 (5 次击中)
    6 → 点亮 s[0]→…→s[4]→s[0] → 全亮 (6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
2026-10-05 feat(buff): 按 2026 规则核对, 增加第一组超时开关 + 记录从机侧规则要求
    规则核对(2026 规则 5.5.2.1 能量机关状态):
    - ✅ 小符: "随机点亮其余4块中的任意一个" → 每轮必是未点亮过的灯板, 共 5 次
    (我们的预打乱排列等价; BUFF_SMALL_HIT_COUNT=5 合规)
    - ✅ 2.5s 超时 / 大符 2 块随机点亮 / 命中后 1s 内可打第二块 / 不论成败重新随机
    - ✅ 大符"组内第一块被击中即视为该组激活成功" → HIT_WINDOW→COOLDOWN→下一组
    - ✅ "重新点亮下一组前熄灭至多 200ms"(原文"至多") → 我们 5ms(老 1ms) 均满足
    - ✅ 组号经帧内 [6] 传从机, 供"中部灯臂 k/5 进度"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
2026-10-05 fix(buff): 大符轮次切换的"熄灭旧对"真正生效(间隔 5ms→150ms)
    问题(规则核对时发现): 规则要求"重新随机点亮下一组装甲模块前, 灯臂和装甲模块灯效将熄灭
    至多 200ms", 但旧的两个灯板实际不会被熄灭。
    定位: 主机确实发了熄灭帧(BF_EXTINGUISH, 显式携带当前对 panel_a/panel_b), 但**熄灭→点亮
    只隔 5ms**; 从机(老从机为 200ms 单缓冲)只会看到后一帧 → 熄灭帧被吞 → 旧对不熄。
    且老代码同此缺陷(熄灭与点亮相隔≈1ms), 2025 实机同样不熄灭, 只是被击中那块的环数显示掩盖了。
    修复: BUFF_EXTINGUISH_GAP_MS 5 → **150ms**
    - 满足规则上限(≤200m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
2026-10-05 revert(buff): 第一块/第一组不计时(BUFF_FIRST_HIT_TIMEOUT_EN 回到 0)
    按队伍确定的行为: 第一块(第一组)不设 2.5s 超时, 无限等待第一次击中, 从第二块起才计时
    —— 与 2025 老固件一致。
    规则 5.5.2.1 的字面表述(激活失败条件含"未能在2.5秒内击中点亮的装甲模块")保留在
    config 注释中备查; 开关保留, 赛前如需切换只改一行。
    主机/从机模板同步为 0。
2026-10-06 fix(sched): 拨码采样从 4Hz 改为 20ms, 响应时间 1s → ~80ms
    问题: bsp_switch_poll() 原先挂在 4Hz 逻辑帧里 + 消抖 4 次 → 拨一下开关要
    4×250ms = 1 秒才生效(老代码约 1ms 读取)。停/转、大小符的手感明显变钝。
    修改:
    - config_board.h: 新增 SWITCH_POLL_DIV=20(采样周期 20ms), SWITCH_DEBOUNCE_TICKS 保持 4
    → 机械抖动(<10ms)被滤掉, 4 次一致 ≈80ms 生效
    - it.c: 1ms 中断里按 SWITCH_POLL_DIV 分频采样拨码, 并在同一处应用
    motor_set_run()/motor_set_mode(); 4Hz 逻辑帧只留 buff_step()/light_tick()
    - 从机模板 config_board.h 同步(角色保留)
    至此主机代码侧功能完整。
2026-10-06 docs(slave): 新增《从机重构清单》(详细版), 为从机重构做准备
    内容(逐条对照 2026 规则 + 2025 老从机固件原文):
    - CubeMX 加回清单: 10 个 EXTI 引脚 + 6 中断; TIM4 全通道 + TIM3 CH2/CH4;
    5 条 DMA 流(方向必须 Memory To Peripheral) + 对应 NVIC; PWM 参数; 波特率 1Mbps
    - 代码改动: config_ws2812 灯带表与缓冲按从机接线重填(先做通道扫描)、
    buff.c 换从机状态机(SLEEP/ARMED/ACTIVATED/ALL_ON + 解码两处细节)、
    新增 hit_detect.c(EXTI→环数查表→armed/fired/locked/mishit)、light.c 图案库、调度与 Keil
    - 协议时序要求: 大符轮次切换的 熄灭/点亮 两帧相隔 150ms, **从机必须 1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
2026-10-06 docs(slave): 新增《从机CubeMX操作说明》(逐步操作+校验命令), 灯板号方案定案
    - docs/从机CubeMX操作说明.md: 步骤 0~9 照着点
    * 步骤0 改工程名(可选) + Keil 重配 Groups/包含路径的提醒
    * 步骤1 EXTI: PA1~PA5/PC6~PC10 双沿线 + No pull + User Label KEY1~KEY10;
    NVIC EXTI1~4/9_5/15_10 = 3/0(含 PA5 与 PC6~9 共用 EXTI9_5 的分发提醒)
    * 步骤2/3 TIM3 CH2/CH4、TIM4 CH1/CH2/CH3 的通道与参数(PSC=2/ARR=34/PWM1/Pulse=0/极性High)
    * 步骤4 DMA 5 条流(Stream 分配表 + 参数表), **Direction=Memory To Peripheral 标注为重中之重**
    * 步骤5 NVIC 汇总核对表(6 个 EXTI + 6 个 DMA + CAN1 + TIM6 + SysTick)
    * 步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
2026-10-06 docs(slave): 从机 CubeMX 校验通过 + 新增《从机代码重构计划》(S0~S7)
    一、CubeMX 校验(用户已改完, 逐项通过):
    - 6 通道 PWM(PA6/PA7/PB1 + PB6/PB7/PB8) 与 6 条 DMA 全部 Memory To Peripheral
    - 10 路 EXTI(KEY1~10, No-pull, 双边沿) + 6 个 EXTI 中断(3/0) + 6 个 DMA 中断(5/0)
    - CAN1 = 1Mbps + ART/ABOM=ENABLE(本次唯一改动); CAN2 保留(bsp_can 主从共用)
    - NVIC: CAN1/2=1, TIM6=2, 分组 GROUP_4; USER CODE(it.c 调度器/main.c 初始化)保留
    - 说明: 生成代码本就带 TIM4/EXTI(从机模板取自主机裁剪前快照), 故本次只有 can.c 变更
    二、新增 docs/从机代码重构计划.md(与主机同风格的阶段化计划):
    - 总体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
2026-10-06 docs: 文档收尾(从机计划/遗留待办/入口页精简) + 从机 Drivers 入库
    新增 docs/遗留待办与开放问题.md(总览, 单一出处, 完成即销项):
    - 主机待办 7 项(电机圈时间标定/上电色序专项/烤机/U15/三项已定规则留白)
    - 从机待办 10 项(S1~S7 映射, 含"通道扫描先做"、RDET9 环数核对、进度 n/5、全激活外观、5 块板联机)
    - 硬件与他人确认 6 项(5 块板编号/STB 接法/U15/波特率复核/机械布局/CAN2 保留与否)
    - 仓库事项 3 项(18 个提交未推送、文档母版与副本同步、从机工程改名)
    完善既有文档:
    - 重构对照: 新增 6.3 完整环数标定表(RDET1~10 + RDET9 疑点 + 1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
2026-10-06 chore: 加 .gitattributes 统一换行符(仓库存 LF, 工作区检出 CRLF)
    背景: 文档/源码在 Windows 下被脚本与编辑器反复在 CRLF/LF 之间翻转,
    导致每次改一处就产生"整个文件都变了"的噪声 diff(如《重构对照》一次差 2114 行)。
    改动:
    - 新增 .gitattributes: *.md/*.txt/*.c/*.h/*.s/*.ioc/*.uvprojx/*.uvoptx 统一
    仓库内按 LF 存储、工作区检出为 CRLF(Windows 友好); 二进制不设规则
    - git add --renormalize: 一次性归一化 88 个文件(其中 87 个为纯换行符变化, 内容未变)
    效果: 今后脚本写入 CRLF 也会在提交时被归一化, diff 只反映真实内容改动。
2026-10-06 docs: 文档对齐现架构 + 冗余合并(净 -133 行)
    修正六处漂移, 顺带清掉同类问题:
    - README 进度表 P4~P6 → ✅(已完成); 文档表按合并后职责重写
    - buff.c 文件头: 熄灭间隔 5ms → 150ms(并补"老从机 200ms 单缓冲吞帧"的原因)
    - 代码架构设计: BUFF_EXTINGUISH_GAP_MS 250u→150u、拨码 4Hz→20ms(5 处)、
    架构图"DMA 完成中断→Stop"改为"清 busy"(实现里不调 Stop_DMA)、§五 遗留项更新
    - 重构对照: app/{common,master,slave}/* → application/*; §4.2 由"中断置标志+主循环"
    改为实际的 TIM6 内调度; §9 文件树与标定核对表(→13 项)按实际文件与状态重写
    - 遗留待办 R1: 写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
2026-10-06 feat(slave): 从机 S1 config 从机化完成(S0 基线一并验过)
    - config_board.h: BOARD_ROLE_MASTER=0; 新增 SLAVE_PANEL_NUM(1~5) 并加 #error 越界检查
    (防板号写错导致本机永不点亮; 要求固件文件名带板号); 从机无电机 → SW2 挪作白光扫描触发
    - config_ws2812.h: 灯带表 1 条 → 6 条(TIM3 CH1/CH2/CH4 + TIM4 CH1/CH2/CH3), 灯数单点定义
    WS_LED_NUM_UP/TARGET/ARM/ARM_SIDE/DOWN/SPARE(老口径 87/262/320/120/92/0, 待 S2 实测回填),
    全为 0 时 #error
    - bsp_ws2812.c: 6 对缓冲由 WS_LED_NUM_* 推导(不再"改表忘改缓冲"); 实测 .bss 46208B≈45.1KB,
    数据区 128KB 且 Keil scatter 不含 CCM → 不会误放到 DMA 访问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
2026-10-06 feat(slave): 对照老从机做功能一致性核查, 并把 S2 通道扫描调到"拿去就能扫"
    修掉一个 S2 阻塞:
    - WS_LED_NUM_SPARE 0u → 90u 试探值。白光扫描(light_tick)只遍历 led_num>0 的通道,
    填 0 的话 S2.3"PB8 到底接没接灯带"永远扫不到、永远得不到答案; 不亮再改回 0u。
    缓冲随之增大: 实测 .bss 50,746B≈49.6KB / 数据区 128KB(synchk + arm-none-eabi-size 复核)
    对照老从机(main.c/gpio.c/bsp_can.c/Divice/WS2812.c)查出的 3 个"不写下来必踩"的问题:
    - 触发沿: 老从机 10 路是 IT_FALLING 单边沿, 本工程 CubeMX 现为 RISING_FALLING
    → 一次击打两个沿, 第二个沿落在 HD_FIRED 状态会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
2026-10-09 fix(slave): S1/S2.1 验收修复 —— EXTI 沿收敛为 FALLING、去重复宏、拨码采样 20ms
    验收结论: S1(config 从机化) 与 S2.1(灯带缓冲) 均通过; 以下为本轮发现并修掉的问题。
    1) ★ EXTI 触发沿(用户一致性核查发现, 属关键缺陷, 已直接落地):
    老从机 10 路是 GPIO_MODE_IT_FALLING(只下降沿), 而本工程最初误配成 RISING_FALLING
    → 一次击打产生两个沿(击打+回弹), 第二个沿到达时状态已非"待激活", 会被判"打错"
    → 上报 [2]=0x01 → 主机整轮复位。
    校验依据: 老从机 Core/Src/gpio.c 全为 IT_FALLING + NOPULL(整季验证)。
    修复: .ioc 的 10 处 GPIO_ModeDefaultEXTI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
2026-10-10 docs(slave): 新增《从机通道扫描指南》(S2 操作手册) + 三处索引
    内容(结构参照主机《白光测试指南》, 按从机 6 通道/SW2 触发改写):
    - 为什么必须做: 老口径未在 2027 板验证 / 丝印不可信(主机板教训) / S6 图案依赖索引映射 / 顺带验驱动
    - 扫描原理与行为: SW2 拨 ON → 约 80~100ms 生效(20ms 采样+4 次消抖) → 每 2s 轮换一条
    (其余全灭) → 无限循环; 一轮 16s; 扫描顺序=灯带表行号 + 索引/引脚/老口径对照表
    说明 PB8 为何填 90 试探值(灯数 0 会被 light.c 跳过而永远扫不到)
    - 操作步骤 7 步(接线检查 → 烧录 → SW2 ON → 观察/录像/读 g_dbg_ws_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
2026-10-10 docs(slave): 通道扫描指南补进三处索引(仓库README/从机README/重构清单§6.1+验收①)
2026-10-10 docs+config(slave): 修正 S2 定位 —— 口径继承(无需标定); 从机未接拨码开关
    用户澄清两点, 均成立, 据此修正(避免过度设计):
    1) 硬件与 2025 完全相同 ⇒ 老从机的灯数(87/262/320/120/92)与"索引↔功能"映射**就是规格**,
    无需实测标定。已核对 config_light.h 的 SLV_STRIP_* 与老代码 DMA 绑定逐条一致
    (TARGET=1/ARM=2/ARM_SIDE=3/UP=0/DOWN=4)。
    2) 从机板**未接拨码开关** —— 悬空+内部上拉使 SW_* 恒为高(恒"激活"), 因此:
    - ★ 立即修隐患: TEST_TRIGGER_USE_SW2 1 → 0(否则从机一上电就永久进入扫描模式!)
    - PB8(索引5) 按老行为 WS_LED_NUM_SPARE 90 → 0(不分配/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
2026-10-10 docs+config(slave): 复核 S2 口径继承改动(清 8 处自相矛盾) + S3 设计定稿
    复核结论: 那次提交的判断都对 —— EXTI 收敛把 .ioc(10 处)与 gpio.c(2 处)**一起**改了,
    重新生成不会回退; TEST_TRIGGER_USE_SW2=0 避开了"悬空拨码恒高→一上电就永久扫描";
    PB8 按老行为置 0 成立(硬件与 2025 相同, 老固件从不驱动该口即事实)。
    《从机灯带自检与排障》的定位(可选工具, 非标定阶段)也合理。
    清掉与新结论打架的旧措辞(8 处):
    - config_ws2812.h: 文件头"灯数待 S2 实测" + 灯带表上方整段"还没在 2027 板上实测过/
    S2 扫描后回填/以实测为准不要相信丝印" →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
2026-10-10 feat(slave): S3.1 落地 —— CAN 出队改到 1ms, 并从机侧关掉主机状态机
    buff.c (从机版)
    - 新增 S3.1 接收路径: void buff_can_rx_poll(void) 由 it.c 在 1ms 节拍调用
    逐帧 bsp_can1_pop → 只认下行 0x161 → buff_frame_parse → **幂等覆盖**目标状态
    (cmd/is_big/is_blue/panel_a/panel_b/round) + frames/seq/bad_frames/age_ms/max_burst
    设计要点: 只做"收帧→更新状态+置事件", 不动灯效不发上报(那些留 4Hz 与 S5);
    幂等覆盖等价于老从机"最后写入者赢", 且主机"全亮一次连发 5 帧"不会丢
    - ★顺带修掉两个真问题: 主机状态机整段用 #if BOARD_ROLE_MASTER 包住
    ① 从机原本会每 250ms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
2026-10-10 docs(slave): 逐条核实外部审查反馈(8 条中 6 条属实) + 修 4 处反馈没扫到的同类问题
    核实结论:
    A1 风险表 3 行缓解指向已废除的 S2 扫描任务 —— 属实 → 改写(口径来自老从机 DMA 绑定;
    PB8 已按老行为定案; 灯数由"老固件整季实机运行"背书)
    A2 计划 S1 表仍写 TEST_TRIGGER_USE_SW2=1, 与总体策略 #5(已置 0)矛盾 —— 属实 →
    标注"已被后续实测推翻"并指向策略 #5
    A3 "用 HAL_GetTick 证明 ≤1ms" 仪器分辨率不足 —— 部分属实 → 验收改为 Watch
    g_buff_rx.age_ms(1ms poll 自增/收帧清零), 并注明要 µs 级得用 DWT->CYCCNT 或逻辑分析仪
    A4 跨文档 S2 语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
2026-10-10 docs(slave): 计划改为「S3~S6 连续编码 + S7 一次台架」, 并定死测试方法(实机观察+Watch, 不用 CAN 分析仪)
    策略变化(§一 #3 新增 #6):
    - 阶段间不设台架闸门: S3→S4→S5→S6 一次写完, 每阶段只过“静态可验项”
    (编译 0 error 0 warning / 表-缓冲一致 / 与主机协议段 diff / 代码走查);
    所有物理验证集中到 S7 一次做
    - 测试方法定死: 主判据 = 实机观察 + Keil 调试器 Watch 全局变量与结构体;
    **CAN 分析仪/CAN 盒不进计划、不作任何阶段判据**; 发帧一律用真主机或 5 板互连
    - 配套纪律: 每阶段必须交付一个可 Watch 的快照结构体 ——
    S3=g_buff_rx(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
2026-10-10 feat(slave): 落地 S4~S6(hit_detect/从机状态机/图案库) + S8 定稿后的文档同步
    代码(静态验收全过: 全工程 -Wall -Wextra 0/0, 协议段与主机 diff 为空):
    - S4 application/hit_detect.c/.h: EXTI 只记录(引脚+tick 入环), 4Hz 查表判定;
    hit_map 照老原值(KEY9/10=1环, 待 S7 组2 定案); 打错三条件 + HD_IGNORE_MS=100
    二道防线(硬约束①②③); 事件单槽供状态机消费; g_dbg_hit 交付; Keil 工程已加入。
    - S5 buff.c/.h: 收帧在 1ms 逐帧锁存"与本板有关"命令(my_ev_cmd/valid/seq, 广播
    0x03/0x04 不看板号, 0x01/0x02 必须命中) → buff_tick 1ms 消费换态, 4Hz 消费击打
    事件并上报(击中/打错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
2026-10-11 fix(slave): S4~S6 验收反馈逐条核查后修正 2 处(箭头亮度/打错同引脚永久吞) + 文档同步
    核查结论(4 条: 3 真 1 已覆盖):
    - #1 真·修: 老 Buff_Activatable/Arrowhead/Activating 不做阈值化(">0→255"只在从未被
    从机调用的死代码 Buff_Unactivated_*/Heart 里)。按老调用点: 靶面19段/环数段=255(位序
    无关), 箭头/灯臂常亮/全激活=定值10(老 LSB-first 观感≈80, 位序陷阱三处)。新 draw_armed
    原用 scene_color()=255 画箭头 → 箭头亮 3 倍且不在 S7 组4 可调范围。新增 SLV_LEVEL_ARROW
    =10, 箭头改用它; light.c/config_light.h/清单§3.5 的"阈值化"错误表述一并订正为两档表。
    -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
2026-10-12 docs(slave): 新增《从机S7台架测试指南》—— 五组串行台架验收的操作步骤/Watch 判据/记录表/故障树, 并在计划·清单·README 四处回链
2026-10-17 fix(slave): 大符被打中的灯臂立刻熄灭(小符保持老效果常亮) —— 差异表 #20
    问题: 大符每轮点亮一对灯板, 其中一块被击中后外观与"未打中的伙伴"无差别(靶面环数+灯臂常亮),
    没有"这块已经打完了"的视觉反馈。
    根因: 老从机 state3(Buff_Activating) 对 ROAD_4/ROAD_5 一律整条常亮(定值 10), 大小符不分叉;
    S6"纯复刻老从机"把该行为原样搬进了 draw_activated()。
    改动(用户定案: 大符只灭两条灯臂、靶面保留环数; 小符不变):
    - light.c: 新增 s_big(帧[2]) + light_set_big(); draw_activated() 按模式分叉 ——
    小符 = 复刻老效果(ARM+ARM_SIDE 整条常亮)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
2026-10-17 fix(slave): 大符"点亮帧隐含熄灭" —— 消除"3 块板同时亮"(差异表 #21)
    现象(新代码 S7 台架): 大符下偶尔出现 3 块板同时亮(本轮该亮的 2 块 + 1 块该灭的旧板)。
    根因: 老 Decode() 只做"板号命中"匹配 —— 不在 [3]/[5] 里的板收到点亮帧**什么都不做**,
    继续停在原状态; 熄灭帧只要丢一次(主机 send_cmd 是"查一次邮箱满即丢"单帧无重发,
    或总线瞬时错误), 那块板就永远亮着, 与新一轮的 2 块叠成 3 块。
    改动(只做隐式熄灭, 用户定: 不加连发/不加诊断改法):
    - buff.c 的 1ms 逐帧锁存(buff_can_rx_poll): 大符下收到 0x02 点亮帧而本板不在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
2026-10-17 fix(slave): 转态作废在途击打 —— 修"大符被打过的板熄灭后不再亮"(差异表 #22, 真 bug)
    现象(用户台架, 大符): 一块板被打中、到轮次结束熄灭后, 好像很久/再也不亮。
    根因(非 #20/#21 引入, 但被 #20 显形 —— 打过的板灯臂熄灭后不再有"亮着"的错觉):
    击打链路的三个节拍不在一个时间尺度上:
    1ms EXTI 中断写记录环
    4Hz hit_detect_task() 把记录变成事件(此时才看 s_armed!)
    4Hz buff_step() 消费事件 → 进 ACTIVATED / 上报
    记录在环里最长躺 250ms。大符伙伴板在 1s 窗口末尾被打中时, 主机的熄灭帧(150ms 间隔)
    先在 1ms 的 buff_tick 里把状态打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
2026-10-17 fix(buff): 大符随机不再重复同一对 —— 5 组互不相同的组合(主从共享段同步)
    现象: 大符 5 轮里会把"刚才那一对"再点一遍 —— 主机熄灭旧对 → 150ms → 点亮"新对",
    结果亮的还是同两块, 场上看着像 bug。
    根因: buff_random_big() 是 2025 老 generateUniqueRandomArray_BIG_BUFF 的原样移植,
    只约束"组内 a≠b"(arr1 任意重复), 组与组之间不做任何去重。
    主机侧 20 万局实测: 相邻两轮点到同一对 **10.0%**, 一局平均出现 **0.91 次**重复组合。
    做法(改为对"两块组合"做无重复抽样, 不是打补丁式重掷):
    - 5 块板共 C(5,2)=10 种组合 → 先把组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
2026-10-17 feat(master): 大符没被击打时每个周期刷新"新的一对"(不复位、不推进进度)
    需求: 大符点亮一对灯板后一直没被打中 —— 现在第一对会永远亮着(第二对起直接整局复位),
    应该每个周期刷新一次: 熄灭旧对 → 点亮新随机的两个。
    改动(BB_LIT 大符分支):
    - 每 BUFF_BIG_REFRESH_MS(默认 2500ms, 与老的击打时限同值)无击打 → big_refresh_start():
    熄灭旧对 → 150ms(BB_COOLDOWN) → 点亮**新一对**。语义是"换目标", 不是"判失败":
    不推进 s_round(进度/轮数不变, 不会因刷新少打一轮)、不发 0x03 复位。
    - 刷新前先把**已经到达**的从机回报排空再决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
2026-10-17 docs: 销项 R1 —— 本地改动推送 GitHub(含 S4~S6 从机、#20~#22 台架修复、M8/M9 大符随机与周期刷新)
2026-10-17 docs: 新增《重构工作记录》—— 为什么重构 / 重构后好在哪 / 结果展示(含 Git 树截图)
    三段结构(汇报与复盘用, 明细仍以 docs/ 各专项文档为唯一出处):
    ① 为什么重构: 老代码 10 类结构性问题(单文件混写、配置散落且主从口径不一、拷贝残留、
    隐式标志状态机、HAL_Delay 阻塞、协议裸字节、随机数依赖 TIM2、LSB-first 位序、
    num[counter] 越界、板号无护栏) + 四个老 bug(只刷一次/每圈重启 DMA 花屏/复位段裕量/
    上电色序) + 老从机吞熄灭帧 + 进度 n/5 从未实现。
    ② 重构后好在哪: 架构变化逐条"老→新"(分层、TIM6 唯一调度、dirty/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
2026-10-17 docs: 按《去除文章AI味方法》自检修订《重构工作记录》
    对照七条特征逐条改:
    - 删掉全部行内加粗(原 40+ 处)与 ✅⚠🔴 这类当状态路标的 Emoji(完成度改用"完成/进行中/未做/高优先"文字)
    - "多出来的不是逻辑分支, 而是…"这类"先否定再陈述"改成直陈; 开头的"结论先行"段重写, 不再替读者树立不存在的误解
    - 视频那节一句话能说清却做成了表 -> 改回叙述; 2.4 的单行表格同理改成句子
    - 新增能力一节由"项目符号 + 加粗引导语"改成详略不均的段落
    - 表格只保留真正数据密集的六张(问题/老 bug/架构老新对照/已解决问题/完成度/文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
2026-10-17 docs(重构工作记录): 加 ASCII 架构图与文件清单, 全文改成非嵌入式也能读
    面向没学过嵌入式的读者重写:
    - 开头补一段"能量机关是什么"(主板会转、五块灯板是被打的目标、按节奏点亮与击打)
    - 术语换成白话: CAN→"线路/总线指令", 帧→"一条指令", 消抖→"手抖产生的杂散信号",
    复位段→"帧与帧之间的空档", 丢包计数→"丢了几帧", 拨码→"板上的物理开关";
    删掉 S4~S6/P0~P3/RDET9/g_dbg_*/bb_state_t/Fisher–Yates/MSB-first 等内部代号与缩写,
    只保留文件名(附录索引表里是真实文件名, 不动)与几个能立住的具体数字
    (809 行、38KB / 128KB、0.1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
2026-10-17 docs(重构工作记录): 后半部分改为书面语, 与用户改过的前半统一口径
    按前半(标题/作者行/引言)已确立的书面语风格, 把 §1.1 到文末全部改成陈述句, 去掉口语与旁白:
    - 删掉"好处很实在""这一条直接解决了""眼睛看灯，调试器看变量""抱一台仪器""就行""哪天"
    "撞对""不重样""全绿""画法""双击即播""白占""绝不等待""记一笔"等说法
    - 表格每格由口语短句改为名词性表述; 列头改为"老代码的情况/造成的后果""处理方式/确认依据"
    - 两张 ASCII 图内的说明文字同步书面化(业务层调用硬件层…分层即失去意义), 并修正分支竖线与
    ┌─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
2026-10-17 docs(重构工作记录): 第一部分加入"main() 之前 98 行全局变量"实证, 小节顺移编号
    新增 §1.1 最直观的一处: main() 之前 98 行全是变量定义
    - 实测数字(取自 2025 老文件): 老主机 main.c 第 63~160 行 = 98 行、73 行有效代码、
    68 条声明、59 个全局标识符; 老从机 main.c 第 62~113 行 = 52 行、37 条声明、25 个标识符
    - 照录一段原文(带原行号)作为展品: 4 个 extern 灯带数组、9 行注释掉的死函数、
    匿名 enum + BUFF_State、state = 1、num/num2/num3、a/b/w/temp/ii/adada 等
    - 由这段清单直接引出四条结论: 名字无法表意(9 个短名, adada 定义后无人使用)、
    同一件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
2026-10-19 docs: 文档整理 —— 五份合并为两份、已完成记录压缩, 净减 700 余行
    合并(原文内容按"长期价值"重排, 数字全部照抄原文):
    - 新增 docs/CubeMX校验与踩坑.md ← CubeMX裁剪说明 + P3调试指南 + 从机CubeMX操作说明
    结构: ①生成后必查清单(命令 + 主从两列期望值) ②关键数值速查(时钟/时基/CAN/NVIC/EXTI/
    缓冲位置/极性实测) ③坑一 DMA 方向反了(机理: PAR 与 M0AR 互换后扫过 CCR1..OR 冲进
    TIM4/5/6/7; 铁证 TIM3->DMAR=1; 判定以能工作的老工程生成代码为准; 修后必须断电重启)
    ④坑二 EXTI 双边沿 ⑤坑三 CAN 默认引脚与陈旧波特率 ⑥灯带不亮的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
