HonestLeon/2027_Embedded_Buff/(notices)

Notices in the files:
2027_Embedded_Buff_Slave/Core/Src/main.c:
Copyright (c) 2026 STMicroelectronics.
All rights reserved.
This software is licensed under terms that can be found in the LICENSE file
